uestcoelectronics/pressure_transmitter/PIN_MAPPING.xlsx

Sheet: Standards Ref
Standards Reference — Diagnostic Techniques used in this FMEDA
This sheet lists the EN 61508-7:2010 Annex A techniques referenced in column J of the MCU Pin FMEDA. The product is a pressure transmitter (process-industry field device): there is no product-specific functional-safety standard for pressure transmitters (EN 50402 applies to gas detection systems only) — the certification basis is EN 61508-1…-7:2010, applied together with IEC EN 61511-1 for use as a SIF sensor in the process sector. Diagnostic Coverage (DC) values are taken from EN 61508-2:2010 Annex A (Tables A.2–A.14) / EN 61508-7 Annex A as guidance ceilings; the value claimed in column K must be justified per pin in the FMEDA report.
Code | Technique / Measure | EN 61508-7 Reference | Max DC (guidance) | EN 61508-2:2010 Annex A Ref | Where applied in this FMEDA
A.3 | Frequency monitoring | EN 61508-7 A.3 | High (≥99%) | Table A.11 (clock) | HSE / LSE clock cross-check (PC14, PC15, PH0, PH1)
A.4 | Configuration / CPU-register test | EN 61508-7 A.4 | Medium (60-90%) | Table A.4 (processing units) | GPIO configuration check, boot-mode option-byte (PA2, PA15-debug, PH3-BOOT0)
A.5 | RAM test — March-X / March-C− / walking bit | EN 61508-7 A.5 | High (≥99%) | Table A.6 (variable memory ranges) | Background RAM test (linked to VCAP / VDD)
A.6 | Self-test by software | EN 61508-7 A.6 | Medium (60-90%) | Table A.4 (processing units) | Register read-back tests on SPI / I2C, IRQ liveness, injection test on AFE
A.7 | Test pattern / Read-back of outputs / CRC | EN 61508-7 A.7 (A.7.4 = CRC, A.7.5 = time-redundancy) | High (≥99%) | Table A.7 (I/O units), Table A.8 (data paths) | Read-back of digital outputs (BLE_PWR_ON, RST#TI), CRC on RS-485 / SPI / I2C frames, 4-20 mA sweep test
A.8 | Voltage control (over-/under-voltage) | EN 61508-7 A.8 | Medium (60-90%) | Table A.9 (power supply) | BOR + PVD + PVM on VDD / VDDA / VBAT
A.9 | Clock monitoring | EN 61508-7 A.9 | High (≥99%) | Table A.11 (clock) | HSE CSS + LSE/LSI cross-check (XTAL pins, CLK_EN)
A.10 | Watchdog — windowed, 1oo2 with separate time-base | EN 61508-7 A.10 | High (≥99%) | Table A.10 (program sequence) | External window WDT (WDI, NRST), internal IWDG
A.11 | Input comparison / voting (1oo2, 1oo3) | EN 61508-7 A.11 | High (≥99%) | Table A.13 (sensors) | 1oo2 thermistors, 1oo3 Hall switches
A.13 | Analog signal monitoring — range / plausibility | EN 61508-7 A.13 | Medium (60-90%) | Table A.13 (sensors), Table A.7 (I/O units) | All ADC channels (TMP_ADC1/2, VCC_FB, Current_OUT_FB)
A.14 | Test by redundant hardware | EN 61508-7 A.14 | Medium (60-90%) | Table A.8 (data paths) | Echo-test of RS-485 (TI_RTS / LP_UART)
A.16 | Program sequence monitoring | EN 61508-7 A.16 | High (≥99%) | Table A.10 (program sequence) | Token-based watchdog kick (WDI)
A.18 | Protection against unauthorised modification | EN 61508-7 A.18 | Systematic (n/a for DC) | Systematic — EN 61508-2 Tables A.15–A.17; EN 61508-3 (software) | RDP locked, SWD disabled in production (SWDIO, SWCLK, SWO)
Pin direction codes used in column D:
DI = digital input
DO = digital output
DI/O = digital bidirectional / open-drain
AI = analog input
AO = analog output
PWR-IN = supply pin (in)
PWR-GND = ground pin
Conventions / scope:
1. "Safety related" (column F) = YES means the pin participates in the safety function (pressure measurement → 4-20 mA loop → safe-state signalling); the device is the sensor element of a Safety Instrumented Function per IEC EN 61511-1, with the safety function defined per EN 61508-4.
2. "Claimed DC" (column K) is a target value; the FMEDA report (separate document) must justify the value with technique-specific arguments per EN 61508-7 Annex A.
3. Failure modes follow EN 61508-2 Table B.2 (digital I/O) and §7.4.7 (FMEDA technique).
4. Where a non-safety function shares an MCU with a safety function, EN 61508-2 §7.4.2.3 (independence) and EN 61508-3 Annex F (non-interference between software elements) are invoked: non-safety pins must not be able to interfere with the safety output.
5. Diagnostic test intervals shall meet the proof-test interval declared in the system safety manual (typ. < T_PT/100 per EN 61508-2 §7.4.5.2).
Applicable standards for this product (pressure transmitter, SIL 2):
EN 61508-1…-7:2010 — Functional safety of E/E/PE safety-related systems. Certification basis; FMEDA per Part 2 §7.4.7, diagnostic techniques per Part 7 Annex A, DC ceilings per Part 2 Annex A (Tables A.2–A.14).
IEC EN 61511-1 — Functional safety: Safety Instrumented Systems for the process industry sector. Governs application of the transmitter as the sensor element of a SIF.
EN 61326-3-1 — EMC: immunity requirements for safety-related systems and equipment intended to perform safety-related functions (functional safety, SIL 1–3), general industrial applications.
IEC 60770-1 / IEC 60770-3 — Transmitters for use in industrial-process control systems: methods for performance evaluation (Part 3: intelligent transmitters).
Note: EN 50402 (electrical apparatus for the detection of combustible/toxic gases — functional safety of fixed gas detection systems) applies to gas detectors only and has been removed from this FMEDA's reference set.

Sheet: MCU Pin Map
MCU Pin Map — STM32U385RGT7 (U400 / B403)
Package: LQFP64 • Schematic: Schematic Prints.PDF, Sheet 4/7 • Project: Pressure Transmitter
Pin # | Port / Pad Name | Schematic Net | Pin Mode | Peripheral / AF | 4-20 mA | 4-20 mA + HART | LP HART | LP PA | MODBUS | Notes / Diagnostic Ref
1 | VBAT | 3V | Power | — | 3V supply — VBAT (tied to 3V_MAIN; no coin cell) | 3V supply — VBAT (tied to 3V_MAIN; no coin cell) | 3V supply — VBAT (tied to 3V_MAIN; no coin cell) | 3V supply — VBAT (tied to 3V_MAIN; no coin cell) | 3V supply — VBAT (tied to 3V_MAIN; no coin cell) | Supply pin. Diag: continuous VCC monitoring via PC4/VCC_FB ADC (EN 61508-7 A.8 'Power supply monitoring with safety shut-off'; EN 50402 §6.4.4).
2 | PC13 | SW_HALL3 | GPIO Input | GPIO / EXTI13 | SW_HALL3 — Hall switch #3 (U302 AH1913) | SW_HALL3 — Hall switch #3 (U302 AH1913) | SW_HALL3 — Hall switch #3 (U302 AH1913) | SW_HALL3 — Hall switch #3 (U302 AH1913) | SW_HALL3 — Hall switch #3 (U302 AH1913) | Hall input. Diag: cross-comparison with SW_HALL1/SW_HALL2 + plausibility (EN 61508-7 A.4 'Test pattern'; EN 50402 §6.4.7).
3 | PC14-OSC32_IN | XTAL_LF_1 | Oscillator | RCC LSE input | LSE crystal IN — X400 (32.768 kHz) | LSE crystal IN — X400 (32.768 kHz) | LSE crystal IN — X400 (32.768 kHz) | LSE crystal IN — X400 (32.768 kHz) | LSE crystal IN — X400 (32.768 kHz) | LSE clock. Diag: clock-frequency monitoring vs HSE/HSI (EN 61508-7 A.3 'Watch-dog with separate time base'; EN 50402 §6.4.3).
4 | PC15-OSC32_OUT | XTAL_LF_2 | Oscillator | RCC LSE output | LSE crystal OUT — X400 (32.768 kHz) | LSE crystal OUT — X400 (32.768 kHz) | LSE crystal OUT — X400 (32.768 kHz) | LSE crystal OUT — X400 (32.768 kHz) | LSE crystal OUT — X400 (32.768 kHz) | LSE clock. Diag: see pin 3 — frequency cross-check (EN 61508-7 A.3, A.9 'Frequency monitoring'; EN 50402 §6.4.3).
5 | PH0-OSC_IN | XTAL_HF_1 | Oscillator | RCC HSE input | HSE crystal IN — X401 (HF crystal) | HSE crystal IN — X401 (HF crystal) | HSE crystal IN — X401 (HF crystal) | HSE crystal IN — X401 (HF crystal) | HSE crystal IN — X401 (HF crystal) | HSE clock. Diag: CSS (Clock-Security-System) HW failover + frequency monitor (EN 61508-7 A.3, A.9; EN 50402 §6.4.3).
6 | PH1-OSC_OUT | XTAL_HF_2 | Oscillator | RCC HSE output | HSE crystal OUT — X401 (HF crystal) | HSE crystal OUT — X401 (HF crystal) | HSE crystal OUT — X401 (HF crystal) | HSE crystal OUT — X401 (HF crystal) | HSE crystal OUT — X401 (HF crystal) | HSE clock. Diag: see pin 5 — CSS interrupt on HSE failure (EN 61508-7 A.3, A.9; EN 50402 §6.4.3).
7 | NRST | MCU_RESET# | Reset (bidir, OD) | System reset | MCU_RESET# — external WDT/supervisor reset (page 5) | MCU_RESET# — external WDT/supervisor reset (page 5) | MCU_RESET# — external WDT/supervisor reset (page 5) | MCU_RESET# — external WDT/supervisor reset (page 5) | MCU_RESET# — external WDT/supervisor reset (page 5) | Reset input. Diag: external WDT timeout + supervisor brown-out (EN 61508-7 A.10 'Watch-dog'; EN 50402 §6.4.10).
8 | PC0 | TMP_ADC1 | Analog Input | ADC1_IN1 | TMP_ADC1 — thermistor analog input | TMP_ADC1 — thermistor analog input | TMP_ADC1 — thermistor analog input | TMP_ADC1 — thermistor analog input | TMP_ADC1 — thermistor analog input | Analog input. Diag: dual-thermistor diversity + range/plausibility check (EN 61508-7 A.13 'Analog signal monitoring'; EN 50402 §6.4.5).
9 | PC1 | TMP_ADC2 | Analog Input | ADC1_IN2 | TMP_ADC2 — thermistor analog input | TMP_ADC2 — thermistor analog input | TMP_ADC2 — thermistor analog input | TMP_ADC2 — thermistor analog input | TMP_ADC2 — thermistor analog input | Analog input. Diag: see pin 8 — redundant thermistor pair (EN 61508-7 A.13, A.14 'HW redundancy'; EN 50402 §6.4.5).
10 | PC2 | BLE_PWR_ON | GPIO Output (PP) | GPIO | BLE_PWR_ON — BLE module power enable (B600/U600) | BLE_PWR_ON — BLE module power enable (B600/U600) | BLE_PWR_ON — BLE module power enable (B600/U600) | BLE_PWR_ON — BLE module power enable (B600/U600) | BLE_PWR_ON — BLE module power enable (B600/U600) | BLE enable. Diag: read-back via GPIO + BLE comms heartbeat (EN 61508-7 A.6 'Self-test by SW'; EN 50402 §6.4.8).
11 | PC3 | WDI | GPIO Output (PP) | GPIO / timer kick | WDI — external watchdog input (page 5) | WDI — external watchdog input (page 5) | WDI — external watchdog input (page 5) | WDI — external watchdog input (page 5) | WDI — external watchdog input (page 5) | Watchdog kick. Diag: external WDT requires periodic toggle; missed kick triggers reset (EN 61508-7 A.10; EN 50402 §6.4.10).
12 | VSSA | GND | Power | — | Analog ground | Analog ground | Analog ground | Analog ground | Analog ground | Analog ground. Diag: PCB layout audit + ADC offset self-cal (EN 61508-7 A.13; EN 50402 §6.4.5).
13 | VDDA | 3VA | Power | — | 3VA — analog supply rail | 3VA — analog supply rail | 3VA — analog supply rail | 3VA — analog supply rail | 3VA — analog supply rail | Analog supply. Diag: ADC ratiometric self-check using V_REF (EN 61508-7 A.8, A.13; EN 50402 §6.4.4).
14 | PA0 | CD_IRQ | GPIO Input | GPIO / EXTI0 | CD_IRQ — FDC2214 capacitance-sensor interrupt (B405) | CD_IRQ — FDC2214 capacitance-sensor interrupt (B405) | CD_IRQ — FDC2214 capacitance-sensor interrupt (B405) | CD_IRQ — FDC2214 capacitance-sensor interrupt (B405) | CD_IRQ — FDC2214 capacitance-sensor interrupt (B405) | Sensor IRQ. Diag: IRQ-rate plausibility + B405 status-register polling (EN 61508-7 A.6, A.18 'Plausibility check'; EN 50402 §6.4.5).
15 | PA1 | ERRB | GPIO Input | GPIO | ERRB — FDC2214 error flag (B405) | ERRB — FDC2214 error flag (B405) | ERRB — FDC2214 error flag (B405) | ERRB — FDC2214 error flag (B405) | ERRB — FDC2214 error flag (B405) | Sensor error flag. Diag: edge-sensitive IRQ + sensor diagnostic read (EN 61508-7 A.6, A.18; EN 50402 §6.4.5).
16 | PA2 | LP_UART_TX | Unused | — | LP_UART_TX — line inactive (no HART modem, no RS-485) | LP_UART_TX — to B404 DAC8742 HART modem UART_IN (TX from MCU) | LP_UART_TX — to B404 DAC8742 HART modem UART_IN (TX from MCU) | LP_UART_TX — to B404 DAC8742 HART modem UART_IN (TX from MCU) | LP_UART_TX — to U800 SN65HVD485 driver input (RS-485 TX) | UART TX. Diag: protocol CRC + frame-error counter + read-back via UART loopback or peer ACK (EN 61508-7 A.6, A.7 'CRC'; EN 50402 §6.4.6). MODBUS: also check RS-485 DE timing; HART: modem comms heartbeat.
17 | PA3 | LP_UART_RX | AF Input | LPUART1_RX (AF8) | LP_UART_RX — line inactive (no HART modem, no RS-485) | LP_UART_RX — from B404 DAC8742 HART modem UART_OUT (RX to MCU) | LP_UART_RX — from B404 DAC8742 HART modem UART_OUT (RX to MCU) | LP_UART_RX — from B404 DAC8742 HART modem UART_OUT (RX to MCU) | LP_UART_RX — from U800 SN65HVD485 receiver output (RS-485 RX) | UART RX. Diag: protocol CRC + frame-error counter + timeout (EN 61508-7 A.7 'CRC', A.6; EN 50402 §6.4.6). MODBUS: also check RS-485 bus idle/break detection.
18 | VSS_1 | GND | Power | — | Digital ground | Digital ground | Digital ground | Digital ground | Digital ground | Ground. Diag: PCB-design measure (EN 61508-7 A.8; EN 50402 §6.4.4).
19 | VDD_1 | 3V | Power | — | 3V digital supply | 3V digital supply | 3V digital supply | 3V digital supply | 3V digital supply | Supply pin. Diag: see pin 1.
20 | PA4 | DAC_INJ | Analog Output | DAC1_OUT1 | DAC_INJ — DAC1_OUT1 drives XTR111 SET (analog 4-20mA loop-current command) | DAC_INJ — DAC1_OUT1 drives XTR111 SET (analog 4-20mA loop-current command) | DAC_INJ — unused in this variant (LP-HART loop driven by B402 via SPI on PA7) | DAC_INJ — unused in this variant | DAC_INJ — unused in this variant | Analog DAC output. In 4-20 plain variant drives XTR111 SET directly (analog loop-current command). Diag: closed-loop comparison vs Current_OUT_FB (U401 INA190 readback) + range check (EN 61508-7 A.13 'Analog signal monitoring', A.14 'HW redundancy', A.18 'Plausibility check'; EN 50402 §6.4.5).
21 | PA5 | SPI1_SCK | AF Output | SPI1_SCK (AF5) | SPI1_SCK — bus inactive (no SPI peripheral populated) | SPI1_SCK — bus inactive (B404 is UART-mode; no SPI slave) | SPI1_SCK — to B402 DAC161S997 SCLK (LP-HART loop DAC) | SPI1_SCK — bus inactive (no SPI slave in LP-PA) | SPI1_SCK — bus inactive (no SPI slave) | SPI clock. Diag: only active in LP-HART (B402 DAC161S997). Loop-back via Current_OUT_FB closed-loop verification + write-readback where DAC supports (EN 61508-7 A.6 'Self-test by SW', A.13 'Analog signal monitoring'; EN 50402 §6.4.5, §6.4.6).
22 | PA6 | FLT_4-20mA# | GPIO Input (EXTI) | EXTI6 / pull-up | FLT_4-20mA# — 4-20mA fault input from U400 XTR111 (open-drain, active-LOW, EXTI on falling edge) | FLT_4-20mA# — 4-20mA fault input from U400 XTR111 (open-drain, active-LOW, EXTI on falling edge) | FLT_4-20mA# — line inactive (U400 not populated; pin kept as input with pull-up) | FLT_4-20mA# — line inactive (U400 not populated) | FLT_4-20mA# — line inactive (no 4-20mA loop in MODBUS) | Loop fault input (active-LOW). U400 XTR111 asserts FLT on over-temperature / open-load / short. Diag: EXTI on falling edge → immediate safe-state transition; periodic high-level readback for stuck-low detection; cross-check with Current_OUT_FB (U401 INA190) at boot and at runtime. References EN 61508-7 A.6 'Self-test by SW', A.13 'Analog signal monitoring', A.14 'HW redundancy', A.18 'Plausibility check'; EN 50402 §6.4.5 (analog inputs), §6.4.7 (digital inputs), §6.4.11 (safe-state behaviour).
23 | PA7 | SPI1_MOSI | AF Output | SPI1_MOSI (AF5) | SPI1_MOSI — bus inactive (no SPI slave populated) | SPI1_MOSI — bus inactive (B404 is UART-mode) | SPI1_MOSI — to B402 DAC161S997 SDI (LP-HART loop DAC data) | SPI1_MOSI — bus inactive | SPI1_MOSI — bus inactive | SPI MOSI. Diag: only active in LP-HART (B402). Closed-loop verification via Current_OUT_FB (U401 INA190) for commanded vs measured loop current (EN 61508-7 A.13 'Analog signal monitoring', A.14 'HW redundancy', A.18 'Plausibility check'; EN 50402 §6.4.5).
24 | PC4 | VCC_FB | Analog Input | ADC1_IN13 | VCC_FB — supply rail feedback (ADC monitoring of 3V/5V via divider) | VCC_FB — supply rail feedback (ADC monitoring of 3V/5V via divider) | VCC_FB — supply rail feedback (ADC monitoring of 3V/5V via divider) | VCC_FB — supply rail feedback (ADC monitoring of 3V/5V via divider) | VCC_FB — supply rail feedback (ADC monitoring of 3V/5V via divider) | Supply feedback ADC. Diag: continuous VCC monitoring + window comparator U202 TPS3700 where present (EN 61508-7 A.8; EN 50402 §6.4.4).
25 | PC5 | Current_OUT_FB | Analog Input | ADC1_IN14 | Current_OUT_FB — loop-current sense via U401 INA190 (4-20 mA monitoring) | Current_OUT_FB — loop-current sense via U401 INA190 (4-20 mA monitoring) | Current_OUT_FB — loop-current sense via U401 INA190 (LP HART loop monitoring) | N/A — IC not populated | N/A — IC not populated | Loop-current feedback. Diag: closed-loop comparison vs commanded 4-20mA / DAC161S997 output (EN 61508-7 A.13, A.14, A.18; EN 50402 §6.4.5).
26 | PB0 | BLE_EVENT | GPIO Input | GPIO / EXTI0 | BLE_EVENT — BLE module event/IRQ input | BLE_EVENT — BLE module event/IRQ input | BLE_EVENT — BLE module event/IRQ input | BLE_EVENT — BLE module event/IRQ input | BLE_EVENT — BLE module event/IRQ input | BLE event/IRQ. Diag: IRQ-rate plausibility + BLE heartbeat (EN 61508-7 A.6, A.18; EN 50402 §6.4.8).
27 | PB1 | TI_RTS | GPIO Output (PP) | GPIO | TI_RTS — line inactive (no HART modem, no RS-485) | TI_RTS — to B404 DAC8742 UART_RTS (HART modem request-to-send) | TI_RTS — to B404 DAC8742 UART_RTS (HART modem request-to-send) | TI_RTS — to B404 DAC8742 UART_RTS (HART modem request-to-send) | TI_RTS — to U800 SN65HVD485 DE/RE (RS-485 driver/receiver enable) | Shared net TI_RTS routes to B404 UART_RTS (HART variants) OR to U800 DE/RE (MODBUS). Only one IC populated per variant → no electrical conflict. Diag: HART variants — modem RTS/CTS handshake + comms heartbeat; MODBUS — DE/RE timing verification + RS-485 echo check (EN 61508-7 A.6 'Self-test by SW', A.7 'CRC', A.18; EN 50402 §6.4.6).
28 | PB2 | SPI1_CS1 | GPIO Output (PP) / SPI1 NSS | GPIO (4-20 EN) or SPI1_NSS (LP-HART) | 4-20mA enable GPIO — HIGH = U400 XTR111 supply ON (loop output active); LOW = loop disabled (safe-state) | 4-20mA enable GPIO — HIGH = U400 XTR111 supply ON (loop output active); LOW = loop disabled (safe-state) | SPI1_CS1 — to B402 DAC161S997 chip select (LP-HART loop DAC) | PB2 — line inactive (no B402, no U400 in LP-PA) | PB2 — line inactive (no loop, no SPI slave) | Variant-multiplexed pin: in 4-20 / 4-20+HART = 4-20mA power-enable GPIO (controls U400 XTR111 supply, default LOW for safe-state at boot); in LP-HART = SPI1_CS1 to B402 DAC161S997 (active-LOW chip select). Only one role per variant (no electrical conflict). Diag — 4-20 mode: GPIO read-back at boot + closed-loop verification via Current_OUT_FB (U401 INA190) after enable; LP-HART mode: SPI write-readback where supported + closed-loop verification via Current_OUT_FB. Safe-state ensured by default LOW after reset (EN 61508-7 A.6 'Self-test by SW', A.13 'Analog signal monitoring', A.18 'Plausibility check'; EN 50402 §6.4.5, §6.4.7, §6.4.11 'Safe state behaviour').
29 | PB10 | LED_CTRL | GPIO Output (PP) | GPIO | LED drive — status / diagnostic LED (GPIO Output) | LED drive — status / diagnostic LED (GPIO Output) | LED drive — status / diagnostic LED (GPIO Output) | LED drive — status / diagnostic LED (GPIO Output) | LED drive — status / diagnostic LED (GPIO Output) | Status/diagnostic LED driver — HMI indication only, not part of safety function. Diag: GPIO read-back register check confirms commanded state (EN 61508-7 A.6 'Self-test by SW'; EN 50402 §6.4.7 'Digital outputs'). LED failure does not affect safety function — visual diagnostic is supplementary.
30 | VCAP | VCAP | Power | — | VCAP — internal LDO decoupling | VCAP — internal LDO decoupling | VCAP — internal LDO decoupling | VCAP — internal LDO decoupling | VCAP — internal LDO decoupling | Internal LDO cap. Diag: PCB-design measure (EN 50402 §6.4.4).
31 | VSS_2 | GND | Power | — | Digital ground | Digital ground | Digital ground | Digital ground | Digital ground | Ground.
32 | VDD_2 | 3V | Power | — | 3V digital supply | 3V digital supply | 3V digital supply | 3V digital supply | 3V digital supply | Supply pin.
33 | PB12 | BLE_MODE | GPIO Output (PP) | GPIO | BLE_MODE — BLE module mode select (boot/run) | BLE_MODE — BLE module mode select (boot/run) | BLE_MODE — BLE module mode select (boot/run) | BLE_MODE — BLE module mode select (boot/run) | BLE_MODE — BLE module mode select (boot/run) | BLE mode pin. Diag: read-back via GPIO (EN 61508-7 A.6; EN 50402 §6.4.7).
34 | PB13 | SCLK_DSP | AF Output | SPI2_SCK (AF5) | SCLK_DSP — to LCD400 SCL (off-BOM external display option; net routed for variant flexibility) | SCLK_DSP — to LCD400 SCL (off-BOM external display option; net routed for variant flexibility) | SCLK_DSP — display SPI clock to B407 EA DOGS104N | SCLK_DSP — display SPI clock to B407 EA DOGS104N | SCLK_DSP — to LCD400 SCL (off-BOM external display option; net routed for variant flexibility) | Display SPI clock. LP-HART / LP-PA: drives onboard B407 EA DOGS104N. 4-20 / 4-20+HART / MODBUS: routed to external LCD400 SCL header (LCD400 not in BOM — off-board option). Display is HMI only — NOT part of the SIL2 safety function. Diag: display CRC frame check + write-readback where supported; failure of display does not affect safe-state (EN 61508-7 A.7 'CRC'; EN 50402 §6.4.6, §6.4.11 'Safe state behaviour').
35 | PB14 | TFT_MISO | AF Input | SPI2_MISO (AF5) | TFT_MISO — to LCD400 FSO (off-BOM external display option; net routed for variant flexibility) | TFT_MISO — to LCD400 FSO (off-BOM external display option; net routed for variant flexibility) | TFT_MISO — display SPI MISO from B407 | TFT_MISO — display SPI MISO from B407 | TFT_MISO — to LCD400 FSO (off-BOM external display option; net routed for variant flexibility) | Display SPI MISO. LP-HART / LP-PA: from onboard B407 EA DOGS104N. 4-20 / 4-20+HART / MODBUS: routed to external LCD400 FSO header (LCD400 not in BOM — off-board option). Display is HMI only — NOT part of the SIL2 safety function. Diag: display CRC frame check + bus-stuck detection when display absent (EN 61508-7 A.5 'Test pattern', A.7 'CRC'; EN 50402 §6.4.6, §6.4.11 'Safe state behaviour').
36 | PB15 | SDA_DSP | AF Output | SPI2_MOSI (AF5) | SDA_DSP — to LCD400 SDA (off-BOM external display option; net routed for variant flexibility) | SDA_DSP — to LCD400 SDA (off-BOM external display option; net routed for variant flexibility) | SDA_DSP — display SPI MOSI to B407 | SDA_DSP — display SPI MOSI to B407 | SDA_DSP — to LCD400 SDA (off-BOM external display option; net routed for variant flexibility) | Display SPI MOSI / I²C SDA. LP-HART / LP-PA: drives onboard B407 EA DOGS104N. 4-20 / 4-20+HART / MODBUS: routed to external LCD400 SDA header (LCD400 not in BOM — off-board option). Display is HMI only — NOT part of the SIL2 safety function. Diag: display CRC frame check + write-readback where supported (EN 61508-7 A.7 'CRC'; EN 50402 §6.4.6, §6.4.11 'Safe state behaviour').
37 | PC6 | TFT_CS | GPIO Output (PP) | GPIO | TFT_CS — to LCD400 CS1 (off-BOM external display option; net routed for variant flexibility) | TFT_CS — to LCD400 CS1 (off-BOM external display option; net routed for variant flexibility) | TFT_CS — display chip select to B407 | TFT_CS — display chip select to B407 | TFT_CS — to LCD400 CS1 (off-BOM external display option; net routed for variant flexibility) | Display chip select #1. LP-HART / LP-PA: drives onboard B407 EA DOGS104N CS. 4-20 / 4-20+HART / MODBUS: routed to external LCD400 CS1 header (LCD400 not in BOM — off-board option). Display is HMI only — NOT part of the SIL2 safety function. Diag: GPIO read-back register check (EN 61508-7 A.6 'Self-test by SW'; EN 50402 §6.4.7, §6.4.11 'Safe state behaviour').
38 | PC7 | RW_DSP | GPIO Output (PP) | GPIO | RW_DSP — to LCD400 DC (data/command select; off-BOM external display option) | RW_DSP — to LCD400 DC (data/command select; off-BOM external display option) | RW_DSP — display R/W select to B407 | RW_DSP — display R/W select to B407 | RW_DSP — to LCD400 DC (data/command select; off-BOM external display option) | Display R/W or DC select. LP-HART / LP-PA: drives onboard B407 EA DOGS104N R/W. 4-20 / 4-20+HART / MODBUS: routed to external LCD400 DC header (LCD400 not in BOM — off-board option). Display is HMI only — NOT part of the SIL2 safety function. Diag: GPIO read-back register check (EN 61508-7 A.6; EN 50402 §6.4.7, §6.4.11).
39 | PC8 | RESET_DSP | GPIO Output (PP) | GPIO | RESET_DSP — to LCD400 RES (display reset; off-BOM external display option) | RESET_DSP — to LCD400 RES (display reset; off-BOM external display option) | RESET_DSP — display reset to B407 | RESET_DSP — display reset to B407 | RESET_DSP — to LCD400 RES (display reset; off-BOM external display option) | Display reset (active-LOW). LP-HART / LP-PA: drives onboard B407 EA DOGS104N RESET. 4-20 / 4-20+HART / MODBUS: routed to external LCD400 RES header (LCD400 not in BOM — off-board option). Display is HMI only — NOT part of the SIL2 safety function. Diag: GPIO read-back + display ID-readback after reset where supported (EN 61508-7 A.6; EN 50402 §6.4.7, §6.4.11).
40 | PC9 | TFT_TE | GPIO Input | GPIO / EXTI9 | TFT_TE — to LCD400 CS2 (secondary chip select; off-BOM external display option) | TFT_TE — to LCD400 CS2 (secondary chip select; off-BOM external display option) | TFT_TE — display tearing-effect input from B407 | TFT_TE — display tearing-effect input from B407 | TFT_TE — to LCD400 CS2 (secondary chip select; off-BOM external display option) | Display tearing-effect / secondary CS. LP-HART / LP-PA: tearing-effect input from B407 EA DOGS104N. 4-20 / 4-20+HART / MODBUS: routed to external LCD400 CS2 header (LCD400 not in BOM — off-board option). Display is HMI only — NOT part of the SIL2 safety function. Diag: GPIO read-back; failure does not affect safe-state (EN 61508-7 A.6; EN 50402 §6.4.7, §6.4.11).
41 | PA8 | BL1 | AF Output | TIM1_CH1 (PWM) | BL1 — to LCD400 BLK (backlight enable; off-BOM external display option) | BL1 — to LCD400 BLK (backlight enable; off-BOM external display option) | BL1 — display backlight #1 control (B407 region) | BL1 — display backlight #1 control (B407 region) | BL1 — to LCD400 BLK (backlight enable; off-BOM external display option) | Backlight #1 / LCD400 BLK. LP-HART / LP-PA: drives onboard B407 backlight control. 4-20 / 4-20+HART / MODBUS: routed to external LCD400 BLK header (LCD400 not in BOM — off-board option). HMI — NOT part of the SIL2 safety function. Diag: PWM duty / GPIO read-back (EN 61508-7 A.6; EN 50402 §6.4.7, §6.4.11).
42 | PA9 | BL2 | AF Output | TIM1_CH2 (PWM) | N/A — IC not populated | N/A — IC not populated | BL2 — display backlight #2 control (B407 region) | BL2 — display backlight #2 control (B407 region) | N/A — IC not populated | Backlight #2. Diag: see pin 41.
43 | PA10 | LCD_PWR_ON | GPIO Output (PP) | GPIO | LCD_PWR_ON — display power enable (B407 and LCD400 region) | LCD_PWR_ON — display power enable (B407 and LCD400 region) | LCD_PWR_ON — display power enable (B407 and LCD400 region) | LCD_PWR_ON — display power enable (B407 and LCD400 region) | N/A — IC not populated | LCD power. Diag: GPIO read-back (EN 61508-7 A.6; EN 50402 §6.4.7).
44 | PA11 | SW_HALL1 | GPIO Input | GPIO / EXTI11 | SW_HALL1 — Hall switch #1 (U300 AH1913) | SW_HALL1 — Hall switch #1 (U300 AH1913) | SW_HALL1 — Hall switch #1 (U300 AH1913) | SW_HALL1 — Hall switch #1 (U300 AH1913) | SW_HALL1 — Hall switch #1 (U300 AH1913) | Hall input. Diag: cross-comparison with SW_HALL2/3 + plausibility (EN 61508-7 A.4, A.14; EN 50402 §6.4.7).
45 | PA12 | SW_HALL2 | GPIO Input | GPIO / EXTI12 | SW_HALL2 — Hall switch #2 (U301 AH1913) | SW_HALL2 — Hall switch #2 (U301 AH1913) | SW_HALL2 — Hall switch #2 (U301 AH1913) | SW_HALL2 — Hall switch #2 (U301 AH1913) | SW_HALL2 — Hall switch #2 (U301 AH1913) | Hall input. Diag: see pin 44.
46 | PA13 | SWDIO | AF (SWD) | SYS_SWDIO (AF0) | SWDIO — SWD debug data (programming/test only) | SWDIO — SWD debug data (programming/test only) | SWDIO — SWD debug data (programming/test only) | SWDIO — SWD debug data (programming/test only) | SWDIO — SWD debug data (programming/test only) | Debug only. Diag: locked in production firmware (EN 61508-7 A.18 'Protection'; EN 50402 §6.4.11).
47 | VSS_3 | GND | Power | — | Digital ground | Digital ground | Digital ground | Digital ground | Digital ground | Ground.
48 | VDDUSB | 3V | Power | — | VDDUSB — tied to 3V (USB IP unused) | VDDUSB — tied to 3V (USB IP unused) | VDDUSB — tied to 3V (USB IP unused) | VDDUSB — tied to 3V (USB IP unused) | VDDUSB — tied to 3V (USB IP unused) | USB supply tied to 3V. Diag: USB IP disabled in firmware (EN 61508-7 A.18; EN 50402 §6.4.11).
49 | PA14 | SWCLK | AF (SWD) | SYS_SWCLK (AF0) | SWCLK — SWD debug clock (programming/test only) | SWCLK — SWD debug clock (programming/test only) | SWCLK — SWD debug clock (programming/test only) | SWCLK — SWD debug clock (programming/test only) | SWCLK — SWD debug clock (programming/test only) | Debug only. Diag: see pin 46.
50 | PA15 | BLE_RESET | GPIO Output (OD) | GPIO open-drain | BLE_RESET — BLE module reset | BLE_RESET — BLE module reset | BLE_RESET — BLE module reset | BLE_RESET — BLE module reset | BLE_RESET — BLE module reset | BLE reset. Diag: read-back via GPIO + BLE heartbeat (EN 61508-7 A.6; EN 50402 §6.4.8).
51 | PC10 | BLE_RXD | AF Input | USART3_RX (AF7) | BLE_RXD — UART RX from BLE module | BLE_RXD — UART RX from BLE module | BLE_RXD — UART RX from BLE module | BLE_RXD — UART RX from BLE module | BLE_RXD — UART RX from BLE module | BLE UART RX. Diag: protocol CRC + frame error counter (EN 61508-7 A.7; EN 50402 §6.4.6, §6.4.8).
52 | PC11 | BLE_TXD | AF Output | USART3_TX (AF7) | BLE_TXD — UART TX to BLE module | BLE_TXD — UART TX to BLE module | BLE_TXD — UART TX to BLE module | BLE_TXD — UART TX to BLE module | BLE_TXD — UART TX to BLE module | BLE UART TX. Diag: see pin 51.
53 | PC12 | RST#TI | GPIO Output (PP) | GPIO | RST#TI — net inactive (B404 not populated) | RST#TI — reset to B404 DAC8742 HART modem (active-low) | RST#TI — reset to B404 DAC8742 HART modem (active-low) | RST#TI — reset to B404 DAC8742 HART modem (active-low) | RST#TI — net inactive (B404 not populated) | HART modem reset. Diag: GPIO read-back + modem comms heartbeat (EN 61508-7 A.6, A.7; EN 50402 §6.4.6).
54 | PD2 | CLK_EN | GPIO Output (PP) | GPIO | CLK_EN — enables X403 (B405 FDC2214 oscillator) | CLK_EN — enables X402 (B404 HART modem XO) + X403 (B405 FDC2214 XO) | CLK_EN — enables X402 (B404 HART modem XO) + X403 (B405 FDC2214 XO) | CLK_EN — enables X402 (B404 HART modem XO) + X403 (B405 FDC2214 XO) | CLK_EN — enables X403 (B405 FDC2214 oscillator); X402 absent (no HART modem) | Oscillator enable for FDC2214 (and HART modem XO where populated). Loss → loss of capacitance measurement / HART link. Diag: I2C transaction-success rate on B405 + modem-link heartbeat where applicable; clock-frequency monitor (EN 61508-7 A.3 'Watch-dog with separate time base', A.6, A.9 'Frequency monitoring'; EN 50402 §6.4.3, §6.4.6).
55 | PB3 | SWO | AF Output | SYS_JTDO-SWO (AF0) | SWO — SWD trace output (debug only) | SWO — SWD trace output (debug only) | SWO — SWD trace output (debug only) | SWO — SWD trace output (debug only) | SWO — SWD trace output (debug only) | SWD trace, debug only. Diag: see pin 46.
56 | PB4 | TEST_MODE | GPIO Input | GPIO | TEM_MEAS_ON temperature measurement diode bias. / TEST_MODE — production test-mode input (tied/jumper) | TEM_MEAS_ON temperature measurement diode bias. / TEST_MODE — production test-mode input (tied/jumper) | TEM_MEAS_ON temperature measurement diode bias. / TEST_MODE — production test-mode input (tied/jumper) | TEM_MEAS_ON temperature measurement diode bias. / TEST_MODE — production test-mode input (tied/jumper) | TEM_MEAS_ON temperature measurement diode bias. / TEST_MODE — production test-mode input (tied/jumper) | Test mode. Diag: locked low in safety operation; checked at boot (EN 61508-7 A.18; EN 50402 §6.4.11). Measurement on for temp diodes.
57 | PB5 | FLT_TEMP# | GPIO Input | GPIO / EXTI5 | FLT_TEMP# — temperature fault from B701 TMP108 | FLT_TEMP# — temperature fault from B701 TMP108 | FLT_TEMP# — temperature fault from B701 TMP108 | FLT_TEMP# — temperature fault from B701 TMP108 | FLT_TEMP# — temperature fault from B701 TMP108 | Temp fault input. Diag: TMP108 over/under-temp alert + range cross-check vs TMP_ADC1/2 (EN 61508-7 A.13, A.14, A.18; EN 50402 §6.4.5).
58 | PB6 | SD | GPIO Output (PP) | GPIO | SD — shutdown control to B405 FDC2214 | SD — shutdown control to B405 FDC2214 | SD — shutdown control to B405 FDC2214 | SD — shutdown control to B405 FDC2214 | SD — shutdown control to B405 FDC2214 | Sensor shutdown. Diag: GPIO read-back + sensor wake confirmation (EN 61508-7 A.6; EN 50402 §6.4.7).
59 | PB7 | INT_B | GPIO Input | GPIO / EXTI7 | INT_B — interrupt from B405 FDC2214 | INT_B — interrupt from B405 FDC2214 | INT_B — interrupt from B405 FDC2214 | INT_B — interrupt from B405 FDC2214 | INT_B — interrupt from B405 FDC2214 | Sensor interrupt. Diag: IRQ-rate plausibility + status-register polling (EN 61508-7 A.6, A.18; EN 50402 §6.4.5).
60 | PH3-BOOT0 | BOOT0 | Boot select | BOOT0 input | BOOT0 — MCU boot-mode select (tied/jumper) | BOOT0 — MCU boot-mode select (tied/jumper) | BOOT0 — MCU boot-mode select (tied/jumper) | BOOT0 — MCU boot-mode select (tied/jumper) | BOOT0 — MCU boot-mode select (tied/jumper) | Boot select. Diag: tied/strapped; checked at boot (EN 61508-7 A.18; EN 50402 §6.4.11).
61 | PB8 | I2C1_SCL | AF (OD) | I2C1_SCL (AF4) | I2C1_SCL — I2C bus clock (B405 FDC2214, B701 TMP108, EEPROM) | I2C1_SCL — I2C bus clock (B405 FDC2214, B701 TMP108, EEPROM) | I2C1_SCL — I2C bus clock (B405 FDC2214, B701 TMP108, EEPROM) | I2C1_SCL — I2C bus clock (B405 FDC2214, B701 TMP108, EEPROM) | I2C1_SCL — I2C bus clock (B405 FDC2214, B701 TMP108, EEPROM) | I2C SCL. Diag: per-transaction ACK + CRC where supported + bus-stuck detection (EN 61508-7 A.7; EN 50402 §6.4.6).
62 | PB9 | I2C1_SDA | AF (OD) | I2C1_SDA (AF4) | I2C1_SDA — I2C bus data (B405 FDC2214, B701 TMP108, EEPROM) | I2C1_SDA — I2C bus data (B405 FDC2214, B701 TMP108, EEPROM) | I2C1_SDA — I2C bus data (B405 FDC2214, B701 TMP108, EEPROM) | I2C1_SDA — I2C bus data (B405 FDC2214, B701 TMP108, EEPROM) | I2C1_SDA — I2C bus data (B405 FDC2214, B701 TMP108, EEPROM) | I2C SDA. Diag: see pin 61.
63 | VSS_4 | GND | Power | — | Digital ground | Digital ground | Digital ground | Digital ground | Digital ground | Ground.
64 | VDD_3 | 3V | Power | — | 3V digital supply | 3V digital supply | 3V digital supply | 3V digital supply | 3V digital supply | Supply pin.
