uestcoelectronics/pressure_transmitter/BOM/PCBPT910G1_4_20.xlsx

Designator | Footprint | Final Part Number
B403 | QFP50P1200X1200X160-64N | STM32U385RGT7
B405 | QFN50P400X400X80-17N | FDC2214RGHR
B700 | Button 2.7x3mmx1.4mm | TBE-Q-T/R
B701 | BGA6C40P2X3_79X119X62 | TMP108AIYFFT
C100 | C0603 | GRM188R6YA106MA73D
C101 | C0603 | CL10A105KL8NNNC
C102 | C0603 | CL10A105KL8NNNC
C103 | C0603 | GRM188R6YA106MA73D
C104 | C1206 | C1206X102KGRACAUTO
C105 | C0805 | GRM21BC72A105KE01L
C106 | C0402 | GRM155R61H224KE01W
C107 | C0402 | CC0402KRX5R9BB104
C108 | C0402 | CC0402KRX5R9BB104
C109 | ALUM THT F5 D8 H11 | PKRM-050V101MF115-T/A5.0
C111 | C1206 | C1206X102KGRACAUTO
C112 | CAP 1206_3216 - 0.8MM | CC1206KFX7RDBB102
C113 | CAP 1206_3216 - 0.8MM | CC1206KFX7RDBB102
C200 | C0402 | GRM155R62A104KE14D
C201 | C0603 | CL10A226MO7JZNC
C202 | C0603 | CL10A226MO7JZNC
C203 | C0603 | CL10A226MO7JZNC
C204 | C0603 | CL10A226MO7JZNC
C205 | C0603 | CL10A226MO7JZNC
C206 | C0603 | CL10A226MO7JZNC
C207 | C0402 | GRM155R61H105KE05D
C208 | C0402 | GRM155R61H105KE05D
C209 | C0402 | GRM1555C1H3R3CA01D
C210 | C0402 | CC0402KRX5R9BB104
C211 | C0402 | CL05A105KP5NNNC
C212 | C0402 | CC0402KRX5R9BB104
C213 | C0402 | CL05A105KP5NNNC
C214 | C0402 | CC0402KRX5R9BB104
C215 | C0402 | CC0402KRX5R9BB104
C216 | C0402 | CC0402KRX5R9BB104
C217 | C0402 | CL05A105KP5NNNC
C218 | C0402 | CL05A105KP5NNNC
C219 | C0402 | CL05A105KP5NNNC
C220 | C0402 | CL05A105KP5NNNC
C221 | C0402 | CC0402KRX5R9BB104
C222 | C0402 | CC0402KRX5R9BB104
C223 | C0402 | CL05A105KP5NNNC
C224 | C0402 | CL05A105KP5NNNC
C225 | C0402 | CC0402KRX5R9BB104
C300 | C0402 | CC0402KRX5R9BB104
C301 | C0402 | CC0402KRX5R9BB104
C302 | C0402 | CC0402KRX5R9BB104
C400 | C0402 | GRM155R61H105KE05D
C401 | C0402 | CC0402KRX5R9BB104
C402 | C0402 | CC0402KRX5R9BB104
C403 | C0402 | CC0402KRX5R9BB104
C404 | C0402 | CC0402KRX7R9BB103
C405 | C0402 | CC0402KRX5R9BB104
C406 | C0402 | CC0402KRX5R9BB104
C416 | C0402 | CC0402JRNPO9BN120
C417 | C0402 | CC0402JRNPO9BN120
C418 | C0402 | CC0402JRNPO9BN120
C419 | C0402 | CC0402JRNPO9BN120
C420 | C0402 | C0402C102J5RACTU
C421 | C0402 | CC0402KRX5R9BB104
C423 | C0402 | CL05A106MP5NUNC
C424 | C0402 | GRM155R61H105KE05D
C425 | C0402 | GRM155R61H105KE05D
C426 | C0402 | GRM155R61H105KE05D
C435 | C0402 | CL05A106MP5NUNC
C436 | C0402 | GRM155R61H105KE05D
C437 | C0402 | GRM155D81C475ME15J
C438 | C0402 | CC0402KRX5R9BB104
C445 | C0402 | CC0402KRX5R9BB104
C447 | C0402 | CL05A106MP5NUNC
C452 | C0402 | GRM155R61H105KE05D
C459 | C0402 | GRM155R61H105KE05D
C460 | C0402 | GRM155R61H105KE05D
C461 | C0402 | GRM155R61H105KE05D
C462 | C0402 | GRM155R61H105KE05D
C500 | C0603 | CC0603MRX5R6BB106
C501 | C0402 | CC0402KRX5R9BB104
C700 | C0402 | CC0402KRX5R9BB104
C701 | C0402 | CC0402KRX5R9BB104
C702 | C0402 | CC0402KRX5R9BB104
C703 | C0402 | CC0402KRX5R9BB104
C705 | C0402 | CL05A106MP5NUNC
C706 | C0402 | CL05A106MP5NUNC
C707 | C0402 | CL05A106MP5NUNC
C708 | C0402 | CC0402KRX7R9BB103
D100 | DO214AB | SMDJ36CA/TR7
D101 | SOD123 | MMSZ5262BT1G
D102 | SOD-523 | PMEG6002EB,115
D103 | DO214AB | SMDJ36CA/TR7
D201 | SOD-523 | MM5Z5V1ST1G
D202 | SOD-523 | MM5Z5V1ST1G
D400 | SOD-523 | PMEG6002EB,115
D401 | SOD-523 | PMEG6002EB,115
D402 | DO214AC | SMAJ40CA
D403 | SOD-523 | PMEG6002EB,115
D404 | SOD-523 | PMEG6002EB,115
D700 | SOD-523 | PMEG6002EB,115
FB101 | FER 1206_3216 | 2512063007Y0
FB102 | FER 1206_3216 | 2512063007Y0
FB400 | FB0402 | BLM15AG102SN1D
FB401 | FB0402 | BLM15AG102SN1D
FB402 | FB0402 | BLM15AG102SN1D
FB403 | FB0402 | BLM15AG102SN1D
FB404 | FB0402 | BLM15AG102SN1D
FB405 | FB0402 | BLM15AG102SN1D
FB406 | FB0402 | BLM15AG102SN1D
FB407 | FB0402 | BLM15AG102SN1D
J100 | PHOENIX_1984772 | 1984772
J400 | SAMTEC_FTSH-105-01-L-DV-007 | FTSH-105-01-L-DV-007-K
J401 | CONN08_878320828_MOL | 878320828
J402 | CONN08_878320828_MOL | 878320828
J500 | CONN 5x2.54MM | KLS1-207-1-40-S-3X5.5X11
L200 | SMD2_CDRH127_SUM | CDRH127/LDNP-330MC
L400 | C0805 | MLF2012E6R8JT000
L401 | C0805 | MLF2012E6R8JT000
L402 | C0805 | MLF2012E6R8JT000
L403 | C0805 | MLF2012E6R8JT000
LCD400 | BDS154S10Z0TG01 | BDS154S10Z0TG01
LD400 | LED0603 RED | LTST-C190KRKT
P700 | HDR1X2 | M20-9990246
PTC100 | PTC 1812 | 0ZCG0050AF2C
Q100 | PowerPAK SO-8 Dual | SI7938DP-T1-GE3
Q200 | 6-DFN2020 (2.08X2.08) | DMP2065UFDB-7
Q401 | SC-70-6 PowerPAK® | SIA441DJ-T1-GE3
Q402 | SOT23 | MMBT5087LT1G
Q403 | SOT23 | BC817-40LT3G
Q404 | SOT223 | SIHFL9014TR-GE3
Q406 | SOT23 | BC817-40LT3G
Q700 | SOT323, SC70 | PDTC123JU,115
Q701 | SOT323, SC70 | PDTC123JU,115
Q702 | SOT323, SC70 | PDTC123JU,115
R101 | R0402 | RC0402FR-0710KP
R103 | R0402 | RC0402FR-07100KL
R104 | R0402 | RC0402FR-07100KL
R105 | R0402 | RC0402FR-0715KL
R106 | R0402 | RC0402FR-133K74L
R107 | R0402 | RC0402FR-07100KL
R108 | R0402 | RC0402FR-076K8L
R109 | R0402 | RC0402FR-0710KP
R111 | R0603 | RC0603JR-070RL
R202 | R0402 | RC0402FR-07100KL
R203 | R0402 | ERA-2AEB563X
R204 | R0402 | RC0402JR-070RL
R205 | R0402 | RC0402JR-071KL
R206 | R0402 | RC0402FR-07100KL
R207 | R0402 | RC0402FR-074K42L
R208 | R0402 | RC0402FR-0722KL
R210 | R0402 | RC0402FR-07100KL
R211 | R0402 | RC0402FR-07100KL
R212 | R0402 | RC0402FR-071KL
R213 | R0402 | RC0402FR-076K8L
R214 | R0402 | ERA-2AEB563X
R215 | R0402 | RC0402JR-070RL
R217 | R0402 | ERA-2ARB132X
R218 | R0402 | ERA-2AEB8061X
R219 | R0402 | RC0402FR-07100KL
R220 | R0402 | RC0402JR-070RL
R221 | R0402 | RC0402FR-07100KL
R223 | R0402 | RC0402FR-0722KL
R224 | C0402 | CC0402KRX7R9BB103
R225 | R0402 | CRCW040264K9FKED
R226 | R0402 | RC0402JR-070RL
R227 | R0402 | RC0402FR-0724K9L
R228 | R0402 | RC0402FR-074K42L
R230 | R0402 | RC0402FR-07100KL
R231 | R0402 | RC0402FR-07100KL
R232 | R0402 | RC0402JR-070RL
R233 | R0402 | RC0402JR-071KL
R235 | R0402 | RC0402FR-07100KL
R236 | R0402 | RC0402FR-07100KL
R237 | R0402 | RC0402JR-070RL
R238 | R0402 | RC0402JR-071KL
R300 | R0402 | RC0402JR-071KL
R301 | R0402 | RC0402JR-071KL
R302 | R0402 | RC0402JR-071KL
R303 | R0402 | RC0402JR-071KL
R304 | R0402 | RC0402JR-071KL
R305 | R0402 | RC0402JR-071KL
R400 | R0402 | RC0402FR-07100KL
R401 | R0402 | RC0402JR-070RL
R402 | R0603 | RC0603FR-0715RL
R403 | R0402 | RC0402FR-07100KL
R406 | R0603 | RT0603DRE071RL
R408 | R0402 | RT0402BRD0734K8L
R409 | R0402 | RT0402BRD071K2L
R410 | R0402 | RC0402JR-071KL
R411 | R0402 | RC0402FR-07100KL
R412 | R0402 | RC0402FR-133K74L
R413 | R0402 | RC0402FR-0710KP
R433 | R0402 | RC0402FR-07100KL
R434 | R0402 | RC0402JR-0710KL
R435 | R0402 | RC0402JR-0710KL
R437 | R0402 | RC0402JR-070RL
R438 | R0402 | RC0402JR-071KL
R439 | R0402 | RC0402JR-0710KL
R440 | R0402 | RC0402FR-07100KL
R441 | R0603 | RC0603JR-070RL
R442 | R0402 | RC0402FR-07100KL
R443 | R0603 | RC0603JR-070RL
R444 | R0603 | TNPU060327K0AYEN00
R447 | R0603 | RC0603JR-070RL
R451 | R0603 | RC0603JR-070RL
R453 | R0603 | TNPU060327K0AYEN00
R454 | R0603 | RC0603JR-070RL
R456 | R0603 | RC0603JR-070RL
R457 | R0402 | CRCW040210R0FKED
R462 | R0603 | RC0603JR-070RL
R465 | R0402 | RC0402JR-070RL
R466 | R0603 | RC0603JR-070RL
R469 | R0402 | RC0402JR-070RL
R470 | R0402 | RC0402JR-070RL
R473 | R0402 | RC0402JR-070RL
R474 | R0603 | RC0603JR-070RL
R481 | R0402 | CRCW040210R0FKED
R493 | R0402 | RC0402JR-070RL
R507 | R0402 | RC0402FR-133K74L
R508 | R0402 | RC0402FR-071KL
R509 | R0402 | RC0402FR-071KL
R513 | R0402 | RC0402JR-070RL
R515 | R0402 | RC0402JR-070RL
R516 | R0402 | RC0402FR-07100KL
R517 | R0402 | RC0402FR-07100KL
R518 | R0402 | RC0402FR-07100KL
R519 | R0402 | RC0402FR-07100KL
R520 | R0402 | RC0402FR-07100KL
R521 | R0402 | RC0402JR-070RL
R522 | R0402 | RC0402JR-070RL
R523 | R0402 | RC0402JR-070RL
R524 | R0402 | RC0402FR-07100KL
R526 | R0402 | RC0402FR-07100KL
R527 | R0402 | RC0402JR-070RL
R529 | R0402 | RC0402JR-070RL
R530 | R0402 | RC0402JR-070RL
R531 | R0402 | RC0402JR-070RL
R532 | R0402 | RC0402JR-070RL
R533 | R0402 | RC0402JR-070RL
R534 | R0402 | RC0402JR-0710KL
R535 | R0402 | RC0402JR-0710KL
R536 | R0402 | RC0402JR-0710KL
R537 | R0402 | RC0402JR-0710KL
R538 | R0402 | RC0402JR-0710KL
R539 | R0402 | RC0402JR-0710KL
R700 | R0402 | RC0402JR-071KL
R702 | R0402 | RC0402FR-0747KL
R703 | R0402 | RC0402FR-0747KL
R704 | R0402 | RC0402FR-07100KL
R705 | R0402 | RC0402FR-0710KP
R706 | R0402 | RC0402FR-07100KL
R707 | R0402 | RC0402JR-070RL
R708 | R0402 | RC0402FR-0747KL
R709 | R0402 | RC0402FR-0710KP
R710 | R0402 | RC0402JR-071KL
R711 | R0402 | RC0402FR-07100KL
U100 | Choke 4.7x4.5x2 | ACM4520-901-2P-T000
U101 | TSOT-23-8 | LM74502H
U102 | SC70-5 | LMV321IDCKR
U200 | DDA0008E-IPC_A | LMR38020SDDAR
U201 | DRV0006A | TPS71733QDRVRQ1
U202 | 6-WSON (1.5x1.5) | TPS3700DSER
U203 | SOT23_6 | TPS25221DBVR
U204 | 6-WSON (1.5x1.5) | TPS3700DSER
U205 | SOT23_6 | TPS25221DBVR
U206 | SOT23_6 | TPS25221DBVR
U207 | SOT23_6 | TPS25221DBVR
U300 | SOT23 | AH1913-W-7
U301 | SOT23 | AH1913-W-7
U302 | SOT23 | AH1913-W-7
U400 | 10-VSON EXP (3X3) | XTR111AIDRCR
U401 | SC70-6 | INA190A3IDCKR
U500 | DL-CC2340-B | DL-CC2340-B
U700 | DCK5 | SN74LVC1G132DCKR
U701 | 8-SON (3x3) | TPS3851H30EDRBT
VR100 | R1206 | AV30K1206201NIR1
VR400 | R1206 | AV30K1206201NIR1
X400 | 4-SMD (3.2MMX2.5MM) | C3E-24.000-12-1015-X-R
X401 | 2-SMD (1.60MM X 1.00MM) | ECS-.327-12.5-16-TR
X403 | 4-SMD (3.2MMX2.5MM) | MCSJK-3N-40.00-3.3-25-C
