uestcoelectronics/pressure_transmitter/4-20.PDF

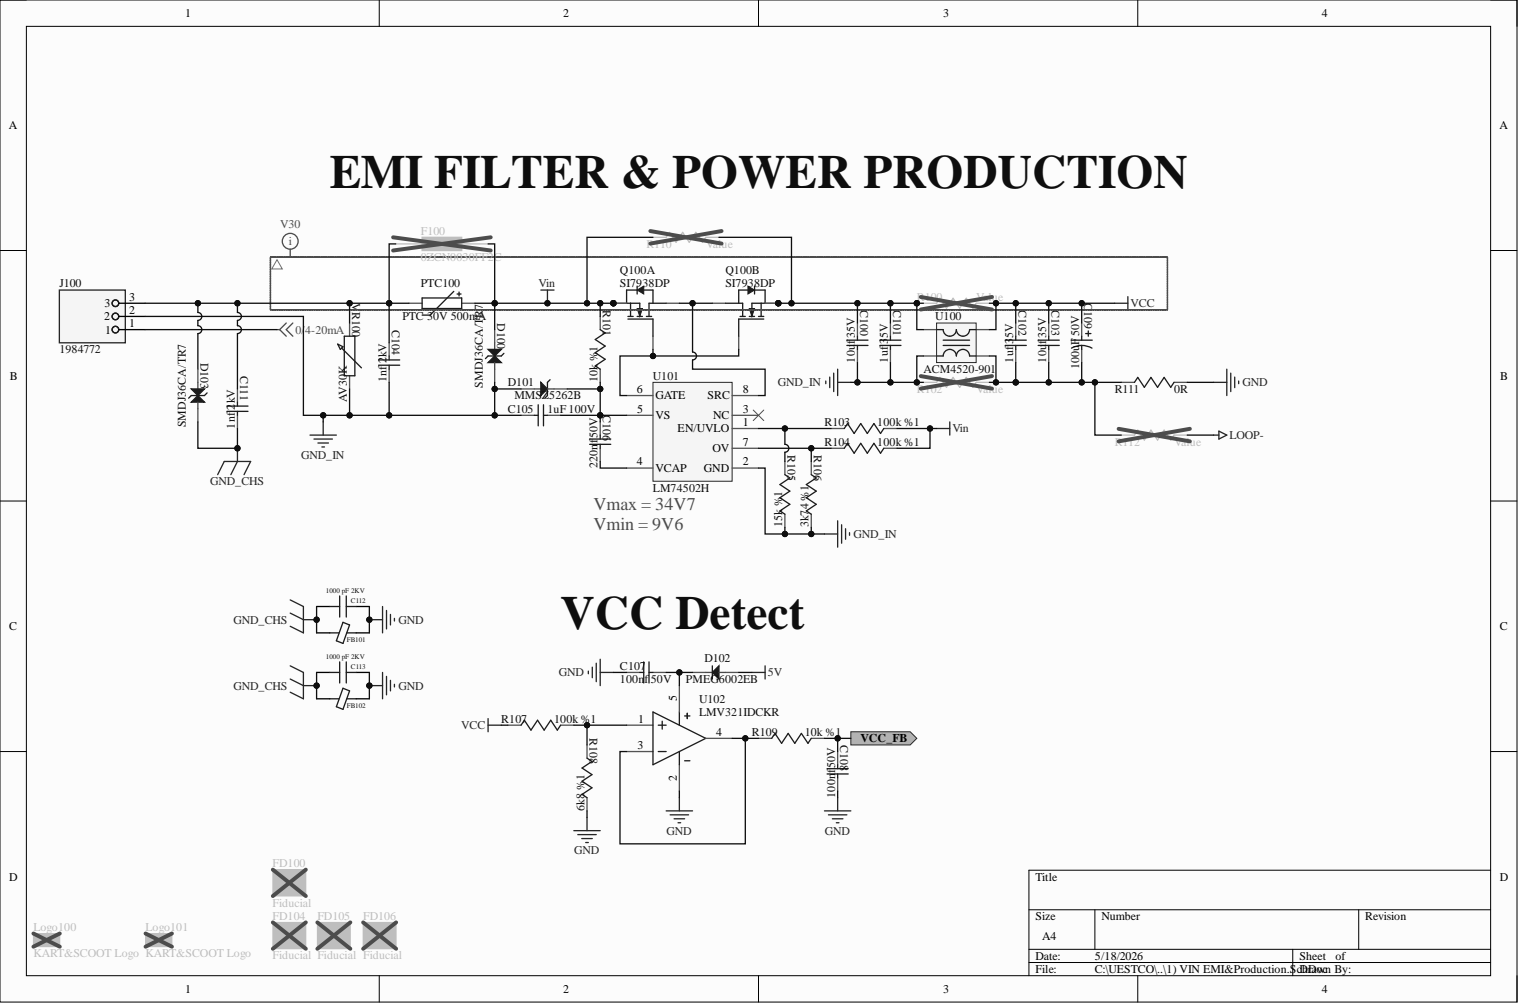
[picture p1: page 1]

EMI FILTER & POWER PRODUCTION

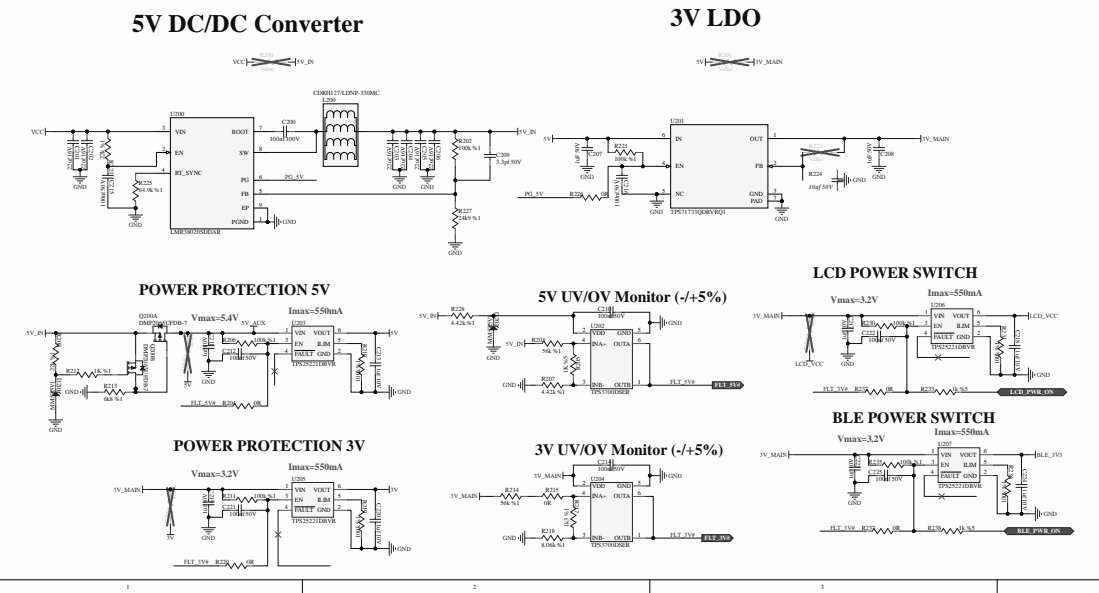
[picture p2: page 2]

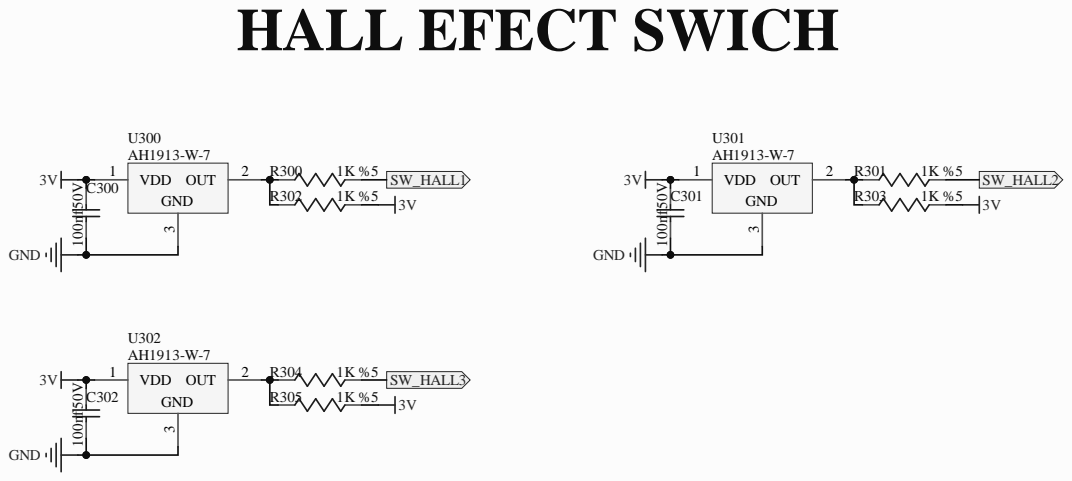
[picture p3: page 3]

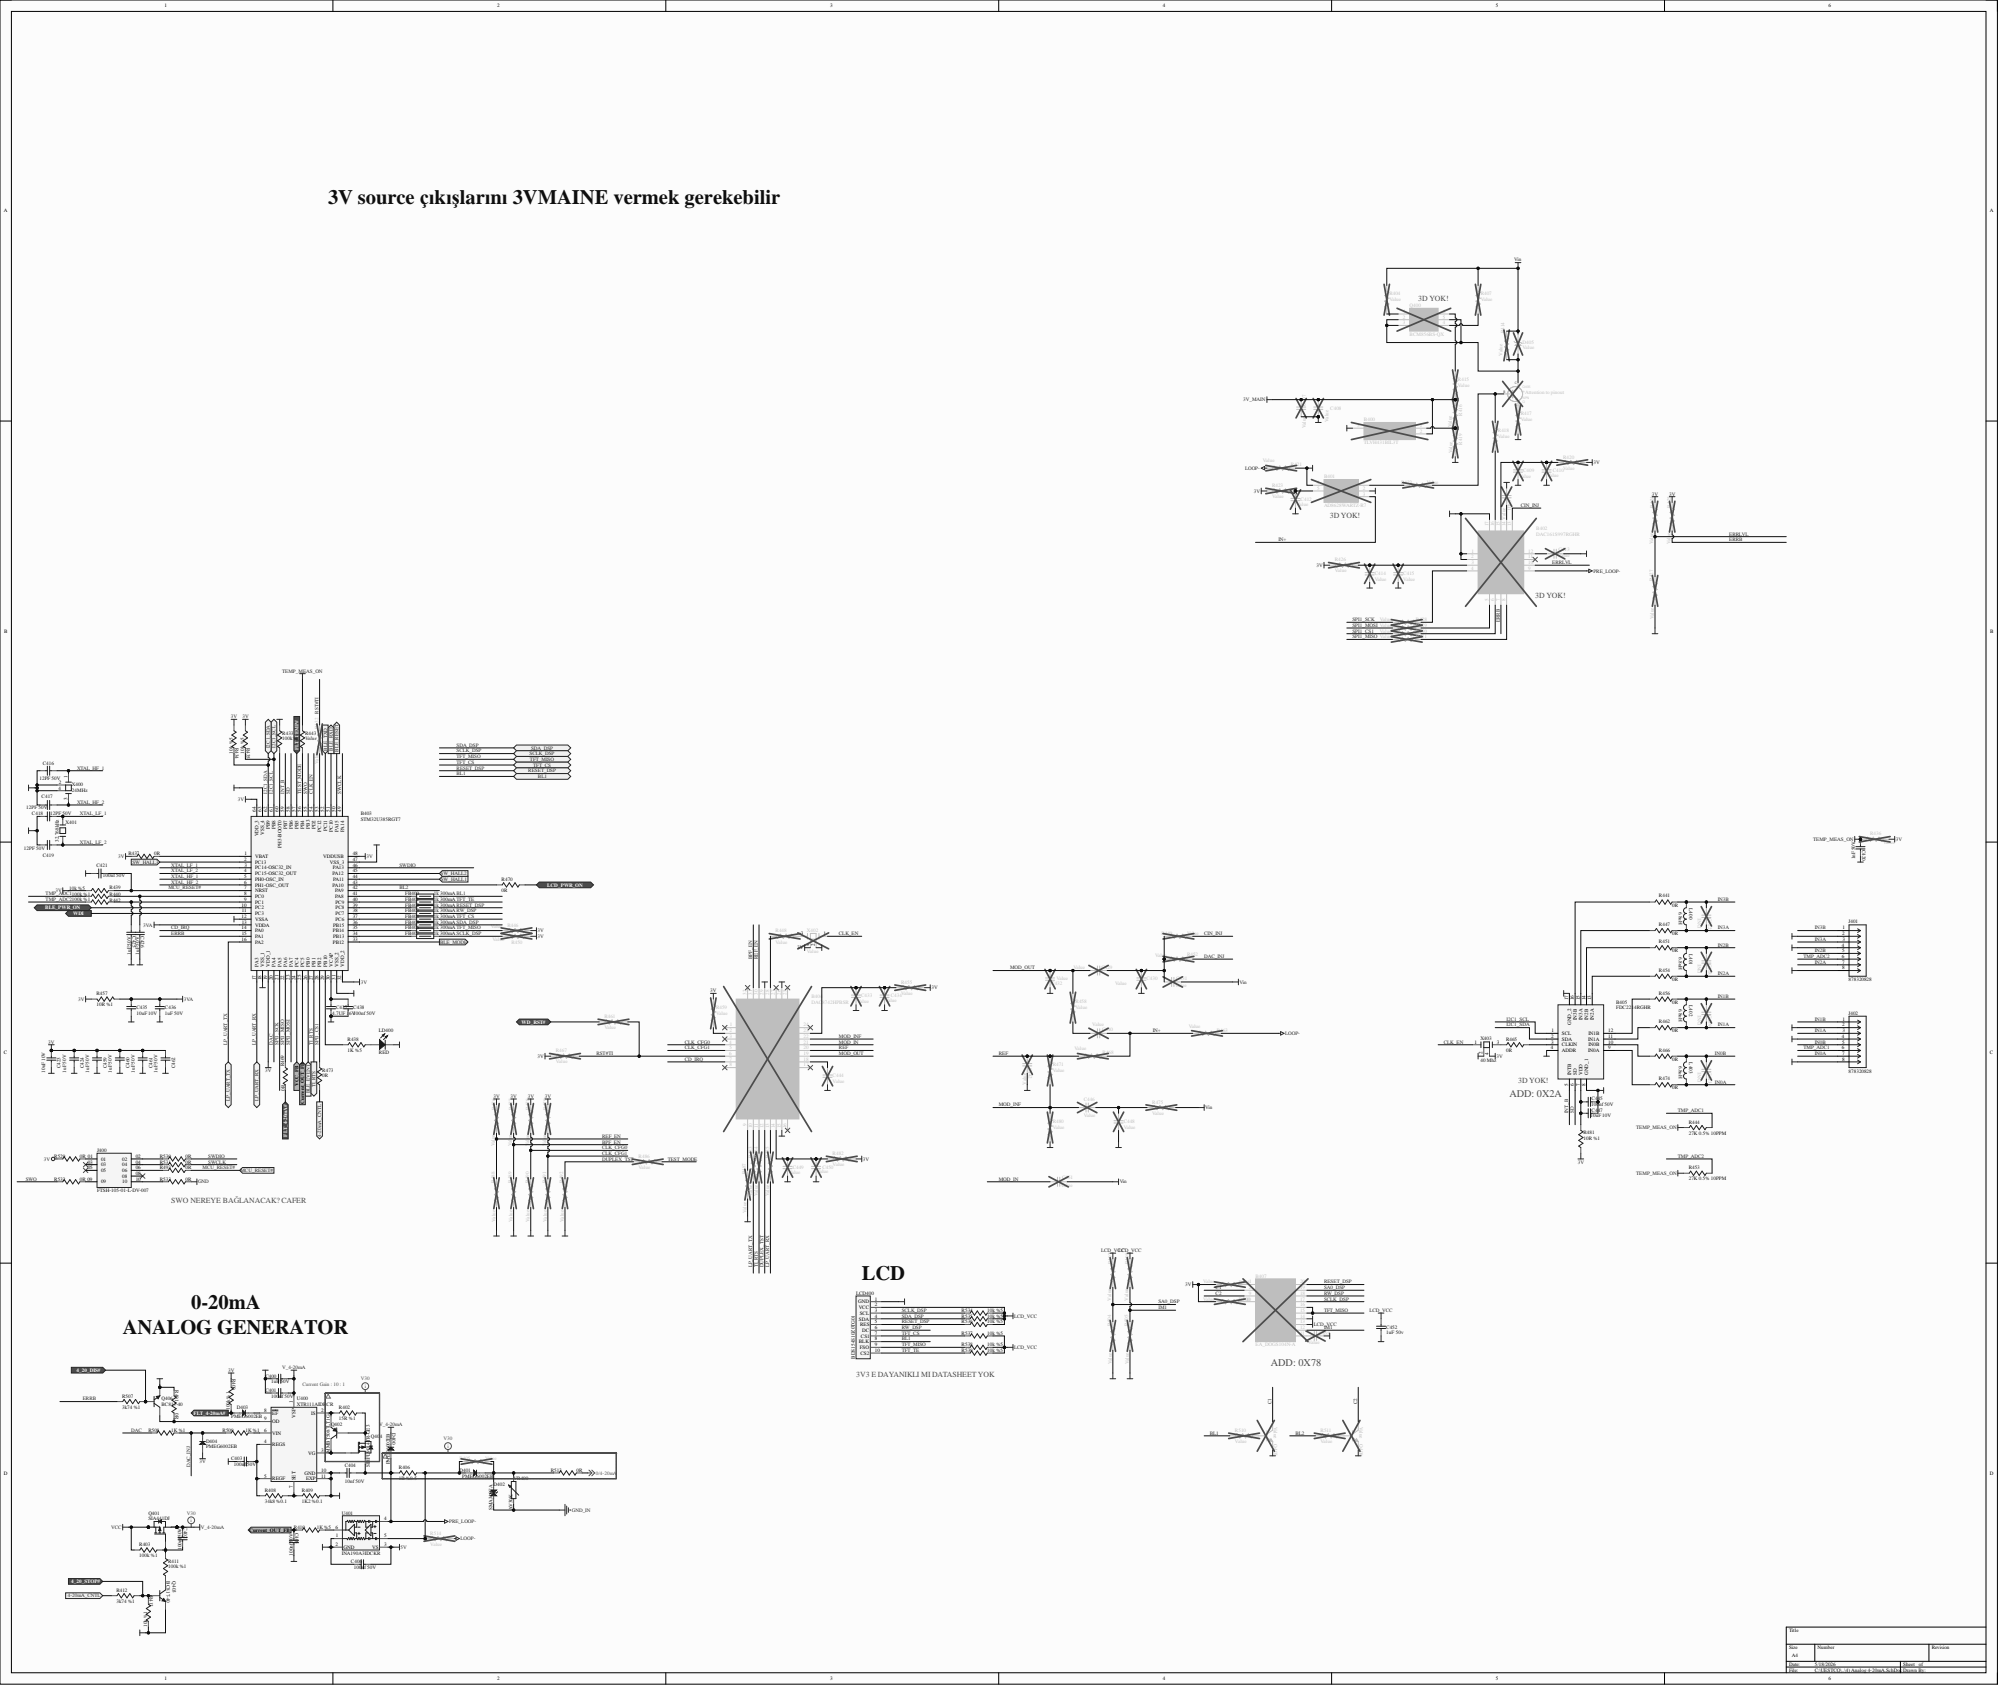
[picture p4: page 4]

3V source çıkışlarını 3VMAINE vermek gerekebilir

SWO NEREYE BAĞLANACAK? CAFER

3V3 E DAYANIKLI MI DATASHEET YOK

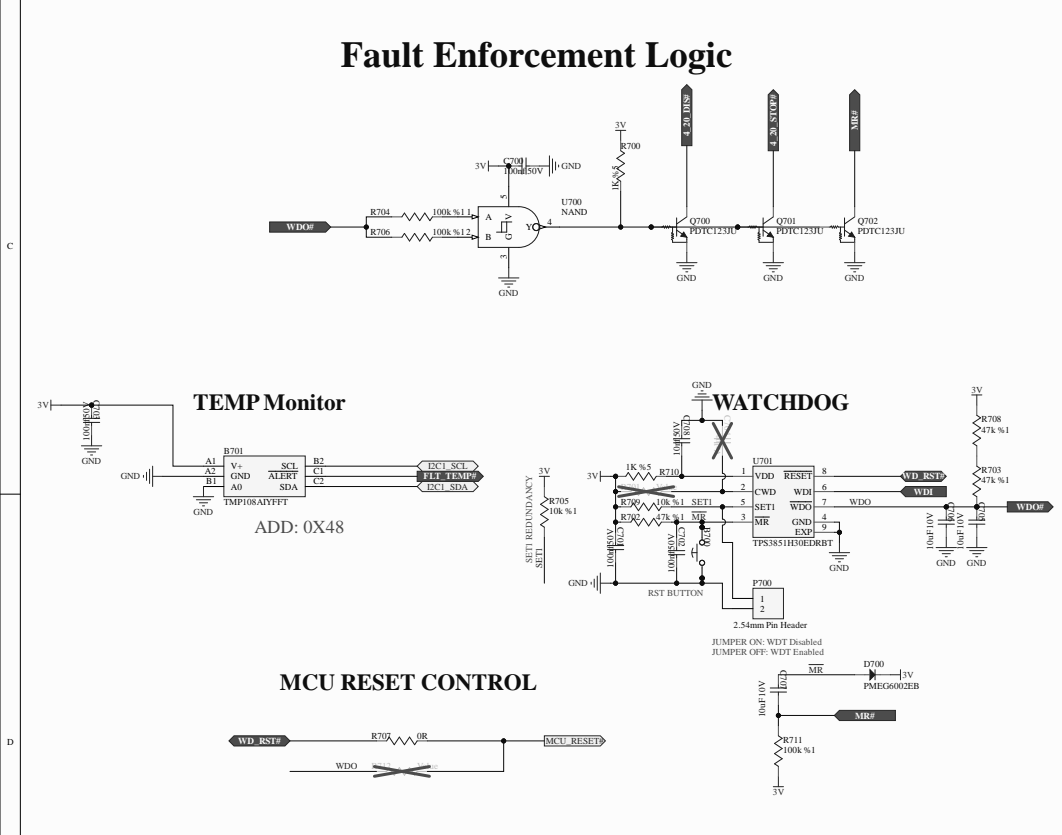
[picture p5: page 5]

JUMPER ON: WDT Disabled
JUMPER OFF: WDT Enabled

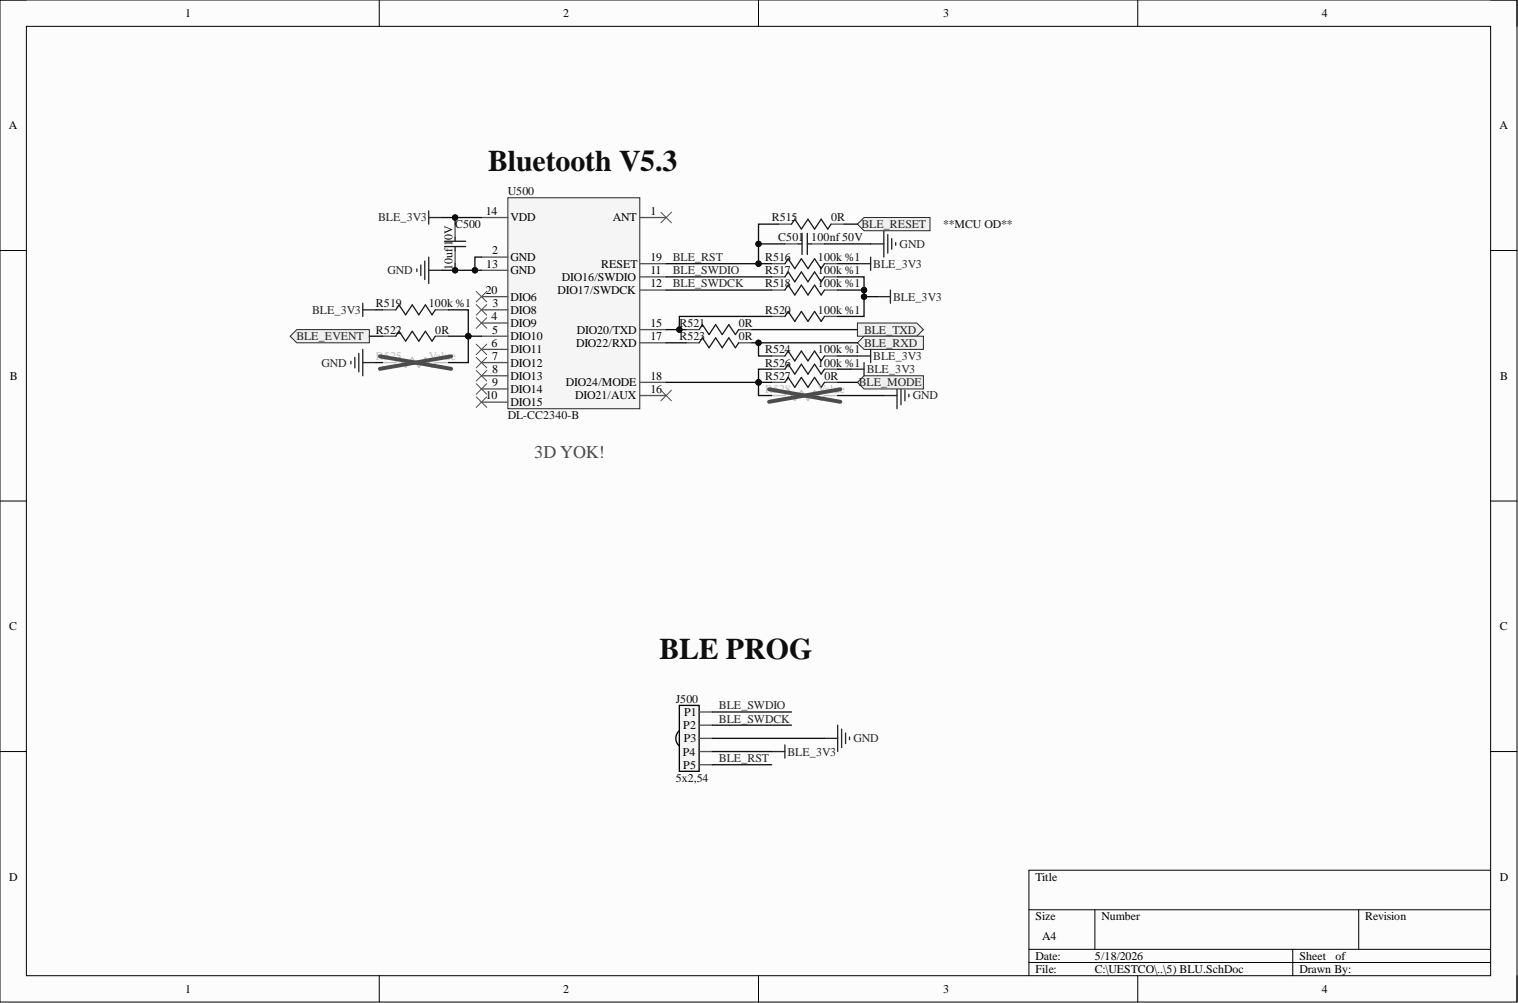
[picture p6: page 6]

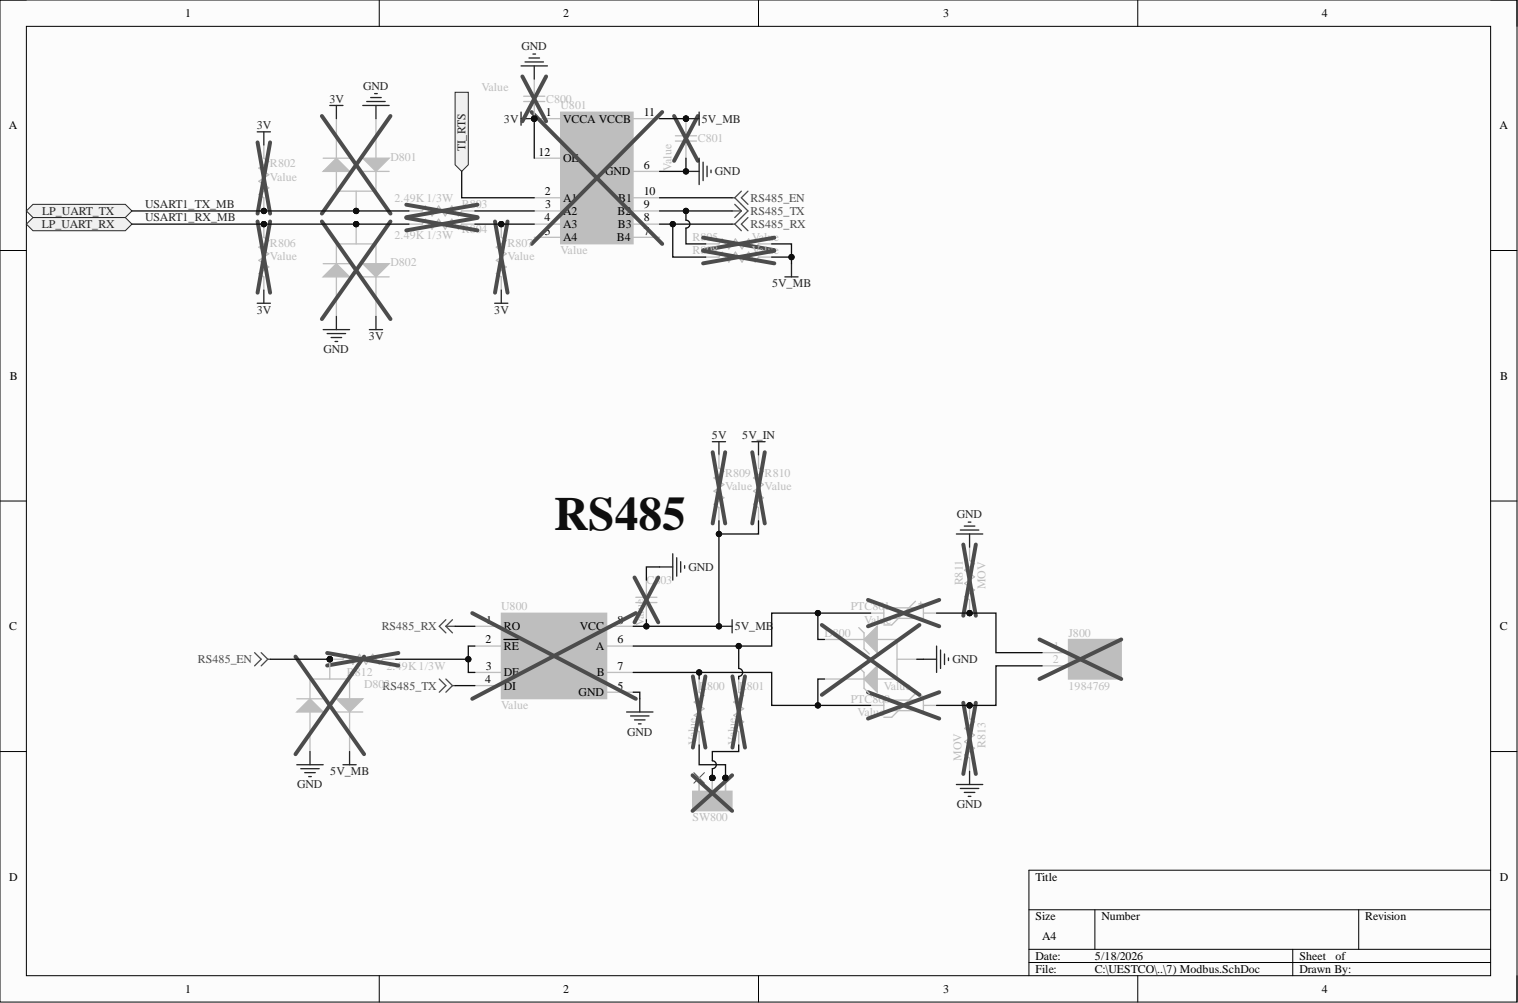
[picture p7: page 7]
