uestcoelectronics/pressure_transmitter/Firmware/Core/Src/main.c

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
/* Includes ------------------------------------------------------------------*/
#include "main.h"
#include "adc.h"
#include "dac.h"
#include "gpdma.h"
#include "i2c.h"
#include "iwdg.h"
#include "spi.h"
#include "tim.h"
#include "usart.h"
#include "gpio.h"

/* USER CODE BEGIN Includes */
#include "pressure_app.h"
#include "buttons.h"
#include "xtr111_loop.h"
#include "tmp108.h"
/* USER CODE END Includes */


void SystemClock_Config(void);
/**
  * @brief  The application entry point.
  * @retval int
  */
int main(void)
{

  /* MCU Configuration--------------------------------------------------------*/

  /* Reset of all peripherals, Initializes the Flash interface and the Systick. */
  HAL_Init();

  /* Configure the system clock */
  SystemClock_Config();

  /* Initialize all configured peripherals */
  MX_GPIO_Init();
  MX_GPDMA1_Init();
  MX_ADC1_Init();
  MX_DAC1_Init();
  MX_I2C1_Init();
  MX_IWDG_Init();
  MX_SPI2_Init();
  MX_TIM1_Init();
  MX_USART3_UART_Init();
  /* USER CODE BEGIN 2 */
  pressure_app_init();
  /* USER CODE END 2 */

  /* Infinite loop */
  /* USER CODE BEGIN WHILE */
  while (1)
  {
    pressure_app_loop();
    /* USER CODE END WHILE */

    /* USER CODE BEGIN 3 */
  }
  /* USER CODE END 3 */
}

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
/* USER CODE BEGIN 4 */
/**
 * EXTI Falling-edge callback (HAL otomatik çağırır).
 * 3 Hall butonu (UP/DN/SET) + XTR111 fault input için pinleri yönlendir.
 */
void HAL_GPIO_EXTI_Falling_Callback(uint16_t pin)
{
    if (pin == BTN_UP_Pin)        buttons_on_edge(BTN_ID_UP);
    else if (pin == BTN_DN_Pin)   buttons_on_edge(BTN_ID_DN);
    else if (pin == BTN_SET_Pin)  buttons_on_edge(BTN_ID_SET);
    else if (pin == LOOP_FLT_Pin) loop_on_flt_edge();   /* enable glitch maskeli */
    else if (pin == FLT_TEMP_Pin) tmp108_on_alert_edge();   /* ortam >60 C */
    /* Diğer EXTI'ler (FDC_INT, FDC_ERRB, BLE_EVENT) şimdilik polling */
}
/* USER CODE END 4 */

/**
  * @brief  Period elapsed callback in non blocking mode
  * @note   This function is called  when TIM6 interrupt took place, inside
  * HAL_TIM_IRQHandler(). It makes a direct call to HAL_IncTick() to increment
  * a global variable "uwTick" used as application time base.
  * @param  htim : TIM handle
  * @retval None
  */
void HAL_TIM_PeriodElapsedCallback(TIM_HandleTypeDef *htim)
{
  if (htim->Instance == TIM6)
  {
    HAL_IncTick();
  }
}

/**
  * @brief  This function is executed in case of error occurrence.
  * @retval None
  */
void Error_Handler(void)
{
  /* USER CODE BEGIN Error_Handler_Debug */
  /* User can add his own implementation to report the HAL error return state */
  __disable_irq();
  while (1)
  {
  }
  /* USER CODE END Error_Handler_Debug */
}
#ifdef USE_FULL_ASSERT
/**
  * @brief  Reports the name of the source file and the source line number
  *         where the assert_param error has occurred.
  * @param  file: pointer to the source file name
  * @param  line: assert_param error line source number
  * @retval None
  */
void assert_failed(uint8_t *file, uint32_t line)
{
  /* USER CODE BEGIN 6 */
  /* User can add his own implementation to report the file name and line number,
     ex: printf("Wrong parameters value: file %s on line %d\r\n", file, line) */
  /* USER CODE END 6 */
}
#endif /* USE_FULL_ASSERT */
