uestcoelectronics/pressure_transmitter/Firmware/PressureTransmitter.ioc

Mcu.UserName=STM32U385RGTx
PA1.GPIO_Label=FDC_ERRB
PA1.Signal=GPXTI1
PA10.GPIO_Label=LCD_PWR_ON
PA10.Signal=GPIO_Output
PA11.GPIO_Label=BTN_UP
PA11.Signal=GPXTI11
PA12.GPIO_Label=BTN_DN
PA12.Signal=GPXTI12
PA4.Signal=COMP_DAC11_group
PA6.GPIO_Label=LOOP_FLT
PA6.Signal=GPXTI6
PA8.Signal=S_TIM1_CH1
PB0.GPIO_Label=BLE_EVENT
PB0.Signal=GPXTI0
PB10.GPIO_Label=LED
PB10.Signal=GPIO_Output
PB12.GPIO_Label=BLE_MODE
PB12.Signal=GPIO_Output
PB13.Signal=SPI2_SCK
PB14.Signal=SPI2_MISO
PB15.Signal=SPI2_MOSI
PB2.GPIO_Label=LOOP_EN
PB2.Signal=GPIO_Output
PB5.GPIO_Label=FLT_TEMP
PB5.Signal=GPXTI5
PB6.GPIO_Label=FDC_SD
PB6.Signal=GPIO_Output
PB7.GPIO_Label=FDC_INT
PB7.Signal=GPXTI7
PB8.Signal=I2C1_SCL
PB9.Signal=I2C1_SDA
PC0.Signal=ADC1_IN1
PC1.Signal=ADC1_IN2
PC10.Signal=USART3_TX
PC11.Signal=USART3_RX
PC12.GPIO_Label=RST_TI
PC12.Signal=GPIO_Output
PC13.GPIO_Label=BTN_SET
PC13.Signal=GPXTI13
PC2.GPIO_Label=BLE_PWR_ON
PC2.Signal=GPIO_Output
PC3.GPIO_Label=WDI
PC3.Signal=GPIO_Output
PC4.Signal=ADC1_IN11
PC5.Signal=ADC1_IN12
PC6.GPIO_Label=LCD_CS
PC6.Signal=GPIO_Output
PC7.GPIO_Label=LCD_DC
PC7.Signal=GPIO_Output
PC8.GPIO_Label=LCD_RST
PC8.Signal=GPIO_Output
PC9.GPIO_Label=LCD_CS2
PC9.Signal=GPIO_Output
PD2.GPIO_Label=FDC_CLK_EN
PD2.Signal=GPIO_Output
