uestcoelectronics/pressure_transmitter/Firmware/Core/Inc/main.h

#define BTN_SET_Pin GPIO_PIN_13
#define BTN_SET_GPIO_Port GPIOC
#define BTN_SET_EXTI_IRQn EXTI13_IRQn
#define BLE_PWR_ON_Pin GPIO_PIN_2
#define BLE_PWR_ON_GPIO_Port GPIOC
#define WDI_Pin GPIO_PIN_3
#define WDI_GPIO_Port GPIOC
#define FDC_ERRB_Pin GPIO_PIN_1
#define FDC_ERRB_GPIO_Port GPIOA
#define FDC_ERRB_EXTI_IRQn EXTI1_IRQn
#define LOOP_FLT_Pin GPIO_PIN_6
#define LOOP_FLT_GPIO_Port GPIOA
#define LOOP_FLT_EXTI_IRQn EXTI6_IRQn
#define BLE_EVENT_Pin GPIO_PIN_0
#define BLE_EVENT_GPIO_Port GPIOB
#define BLE_EVENT_EXTI_IRQn EXTI0_IRQn
#define LOOP_EN_Pin GPIO_PIN_2
#define LOOP_EN_GPIO_Port GPIOB
#define LED_Pin GPIO_PIN_10
#define LED_GPIO_Port GPIOB
#define BLE_MODE_Pin GPIO_PIN_12
#define BLE_MODE_GPIO_Port GPIOB
#define LCD_CS_Pin GPIO_PIN_6
#define LCD_CS_GPIO_Port GPIOC
#define LCD_DC_Pin GPIO_PIN_7
#define LCD_DC_GPIO_Port GPIOC
#define LCD_RST_Pin GPIO_PIN_8
#define LCD_RST_GPIO_Port GPIOC
#define LCD_CS2_Pin GPIO_PIN_9
#define LCD_CS2_GPIO_Port GPIOC
#define LCD_PWR_ON_Pin GPIO_PIN_10
#define LCD_PWR_ON_GPIO_Port GPIOA
#define BTN_UP_Pin GPIO_PIN_11
#define BTN_UP_GPIO_Port GPIOA
#define BTN_UP_EXTI_IRQn EXTI11_IRQn
#define BTN_DN_Pin GPIO_PIN_12
#define BTN_DN_GPIO_Port GPIOA
#define BTN_DN_EXTI_IRQn EXTI12_IRQn
#define BLE_RESET_Pin GPIO_PIN_15
#define BLE_RESET_GPIO_Port GPIOA
#define RST_TI_Pin GPIO_PIN_12
#define RST_TI_GPIO_Port GPIOC
#define FDC_CLK_EN_Pin GPIO_PIN_2
#define FDC_CLK_EN_GPIO_Port GPIOD
#define TEST_MODE_Pin GPIO_PIN_4
#define TEST_MODE_GPIO_Port GPIOB
#define FLT_TEMP_Pin GPIO_PIN_5
#define FLT_TEMP_GPIO_Port GPIOB
#define FLT_TEMP_EXTI_IRQn EXTI5_IRQn
#define FDC_SD_Pin GPIO_PIN_6
#define FDC_SD_GPIO_Port GPIOB
#define FDC_INT_Pin GPIO_PIN_7
#define FDC_INT_GPIO_Port GPIOB
#define FDC_INT_EXTI_IRQn EXTI7_IRQn
