uestcoelectronics/pressure_transmitter/(commit log)

2026-06-12 Initial commit: STM32U385 pressure transmitter firmware + docs
    - Firmware: CubeMX + CMake projesi, App katmani (8 modul), 4-20 mA konfig
    - CARD-0.1 dahil: cal_storage flash yazimi DOUBLEWORD (U3 HAL uyumu)
    - docs/MCU programming: ease-me workspace (roadmap, backlog, state, tracker)
    - BOM, DATASHEETS, PIN_MAPPING (FMEDA), sema PDF
    [PCBPT910G1_4_20.xlsx, PCBPT910G1_4_20_HART.xlsx, PCBPT910G1_LP_HART.xlsx, PCBPT910G1_LP_PA.xlsx, PCBPT910G1_MODBUS.xlsx, PIN_MAPPING.xlsx]
2026-06-12 CARD-0.2: bsp_pins.h pin haritasi mutabakati + workspace guncellemeleri
    - bsp_pins.h: FLT_TEMP (TMP108 alert), BLE_PWR_ON/MODE/RESET/EVENT,
    RST_TI, TEST_MODE alias'lari eklendi
    - ADC yorumlari duzeltildi (1N4148, IN13/IN14) + bilinen sorun notu:
    adc.c rank 2/3 kanal atamasi eksik (.ioc duzeltmesi MANUAL-3)
    - ease-me continuity dosyalari guncellendi (CARD-0.1/0.2/0.3 + CORRECTION-01)
    [bsp_pins.h]
2026-06-12 MANUAL-3: CubeMX ADC regenerate (4 kanal) + bsp_pins ADC_RANK guncellemesi
    - .ioc/adc.c: Rank1=IN1(PC0 diyot#1), Rank2=IN2(PC1 diyot#2),
    Rank3=IN11(PC4 VCC_FB), Rank4=IN12(PC5 I_FB) - rank kanal bug'i kapandi
    - bsp_pins.h: ADC_RANK_TDIODE2 eklendi, COUNT=4, IN11/IN12 duzeltmesi
    - Not: PIN_MAPPING.xlsx IN13/IN14 bilgisi hataliydi (CubeMX teyitli)
    [PressureTransmitter.ioc, bsp_pins.h]
2026-06-12 CARD-1.1: FDC2214 uygulama tarafi bring-up
    - Guc/saat siralamasi: SD toggle + X403 oturma beklemeleri (power_sequence)
    - I2C adres otomatik tespiti: 0x2A -> 0x2B fallback (sema teyidine kadar)
    - ERRB polling: asserted -> STATUS oku, latched hata, alarm-low, SENSOR ERR
    - INT_B data-ready gating; temiz okumada otomatik hata temizleme
    - Init basarisizsa bir kez guc cevrimiyle retry
2026-06-12 CARD-1.2: TMP108 ortam izleme + 60C alert (FLT_TEMP#)
    - Yeni tmp108.c/h: adres tarama (0x48-0x4B), config 0x2230 (continuous,
    1 Hz, comparator, POL aktif-LOW, HYS=4C maks), THIGH=60C / TLOW=-50C,
    config+THIGH read-back dogrulamasi (FH/FL maskeli)
    - pressure_app: 1 Hz poll, AMB HOT >60C ekran onceligi; init olumcul degil
    - main.c USER CODE: FLT_TEMP# (PB5) EXTI -> tmp108_on_alert_edge
    - Rol ayrimi korundu: TMP108 kompanzasyona girmiyor (1N4148 isi)
2026-06-12 CARD-1.3: cift 1N4148 kanal (PC0/PC1) + capraz makulluk
    - temp_diode rework: iki kanal, gecerlilik penceresi (200-1000 mV),
    |T1-T2|<=5C tutarlilik, arbitrasyon (ortalama/fallback/son-deger)
    - is_consistent() + kanal bazli tani getter'lari
    - pressure_app: her iki ADC rank'i besleniyor
    - state_machine bug fix: Vf25/TC edit'i birbirini varsayilana ezmiyor
    [state_machine.c, temp_diode.c, temp_diode.h]
2026-06-12 CARD-1.4: sicaklik rolleri entegrasyonu
    - pressure_app: sicaklik mimarisi rol dokumantasyonu (diyot=kompanzasyon,
    TMP108=ortam+60C alert, failover yok, alarm-low yalniz FDC hatasi)
    - Ekran oncelik zinciri: *FAULT* > SENSOR ERR > TDIODE ERR > AMB HOT > OK
2026-06-12 CARD-2.2: kalibrasyon is akisi saglamlastirma
    - CAL_LIVE stabilite penceresi (8 ornek, dC p2p <= 2000): kararsizken
    yakalama reddi, stabil olunca otomatik mesaj temizleme
    - Span yakalama: |dC - zero| >= 10000 kontrolu (SPAN TOO CLOSE)
    - Save & Exit: cal_validate (dC span + p_max > p_min) + flash hata mesaji
    - Exit (no save): kirli durumda cift onay (Discard? SET again)
    - sm_get_info_msg()/sm_cal_live_stable() API + ekran entegrasyonu
    [state_machine.c, state_machine.h]
2026-06-12 CARD-4.1: loop geri besleme makullugu + NAMUR NE43 alarmlari
    - BUG FIX: komut clamp 3.8..20.5 -> 3.6..21.0 (alarm-low 3.6 mA artik
    gercekten uretiliyor; onceden 3.8'e yuvarlaniyordu)
    - NAMUR NE43 sabitleri; pressure_to_ma aralik disi -> 3.8/20.5 saturasyonu
    - Sapma monitoru: |cmd-meas| > 0.3 mA 2 s -> tani bayragi (cikis degismez),
    LED 5 Hz + ekranda LOOP DEV; alarm bolgesinde pasif
    - XTR111 FLT auto-retry (5 s, FLT pin seviyesi kontrolulu)
    - Header transfer fonksiyonu yorumu duzeltildi (R_SET=1.2k, .c otorite)
    [xtr111_loop.c, xtr111_loop.h]
2026-06-13 CARD-3.1: LCD guc sirasi + uretici ST7789V init dizisi
    - Guc/reset zamanlama sabitleri (PA10 settle 50ms, RST low 10ms,
    RST wait 120ms, SLPOUT 120ms) - datasheet/uretici hizali
    - Uretici guc-kontrol + gamma dizisi eklendi (0xB2/B7/BB/C2/C3/C4/C6/D0
    + 0xE0/E1 gamma) - eksikti, sonuk/yanlis kontrast riski kapandi
    - SWRESET kaldirildi (HW reset yeterli); CS2 makro kullanimi
    - Backlight DISPON sonrasi (acilista garbage flash yok)
    [lcd400.c]
2026-06-13 CARD-3.2: menu SM iyilestirmeleri (timeout/sayfalar/alarm/backlight)
    - 60 s eylemsizlik timeout -> NORMAL (kaydedilmemis degisiklik iptal)
    - NORMAL'de UP/DN ile 3 sayfa: MAIN (P/I/T), SENSOR (dC/Td1/Td2/Tamb),
    LOOP (cmd/meas/err mA)
    - Loop fault'ta adanmis alarm ekrani (render_fault)
    - Backlight (%) menu ogesi - canli lcd_set_backlight, runtime (kalici degil)
    - sm_tick() zaman tabani; menu 12 oge
2026-06-13 CARD-6.2: temel tanilar (diag modulu)
    - Yeni diag.c/h: A.13 ADC rail-stuck (VCC_FB/I_loop, divider-bagimsiz),
    A.7 output GPIO read-back (ODR<->IDR: LOOP_EN/LCD_PWR/BLE_PWR/CLK_EN),
    I2C fiziksel bus recovery (9-clock + STOP + reinit)
    - pressure_app: diag_service sensor tikinde; LOOP_EN read-back kritik ->
    safe state; I2C iki cihaz takilirsa recovery + reinit (cooldown'lu);
    ekranda DIAG CHK
    - diag driver'lara dokunmaz (saglik mevcut API ile gozlenir)
    [diag.c, diag.h]
2026-06-13 CARD-5.1: BLE UART tasima katmani (DL-CC2340-B)
    - Yeni ble_uart.c/h: USART3 IT RX ring buffer (256B, overflow sayacli),
    bloklamali TX; guc sirasi (PWR_ON+MODE wake+RESET darbe+120ms);
    AUX (DIO21->BLE_EVENT) data-ready erisimi
    - USART3 IRQ CubeMX'te kapaliydi -> .ioc DEGISTIRMEDEN app'ten HAL_NVIC
    enable + USART3_IRQHandler ble_uart.c'de (startup zayif sembol override)
    - Datasheet (C19273634.pdf) analizi: baud 115200 uyumlu, pin esleme,
    AT formati, URC'ler -> web_research; MANUAL-5 done
    [ble_uart.c, ble_uart.h]
2026-06-13 CARD-5.2: BLE konfig protokolu (AT init + CRC16 cerceve)
    - Yeni ble_proto.c/h: non-bloklayan AT init SM (RESET->ADVNAME PT910->
    ADVSTA=1->ENTM, OK bekleme+timeout/retry+degraded fallback)
    - Transparent CRC16-CCITT cerceve protokolu [0xAA|LEN|CMD|PAYLOAD|CRC16]:
    GET_MEAS/GET_PARAM/SET_PARAM/SAVE/INFO/UNLOCK; 9 cal parametresi;
    yazma korumasi sabit PIN UNLOCK; vf25/tc temp_diode senkron
    - pressure_app: ble_proto_init + dongu servisi (status byte bitfield)
    - 4-20 guvenlik dongusu BLE bring-up sirasinda durmaz (non-bloklayan)
    [ble_proto.c, ble_proto.h]
2026-06-13 docs: flash/debug altyapisi — Claude headless flash+GDB yapabilir
    - mcu_prog_flash_debug.md: tum araclar kurulu (Programmer CLI v2.21 +
    ST-LINK_gdbserver 7.13 + arm-none-eabi-gdb); is bolumu; komutlar
    - tools/: flash.bat, probe_test.bat, gdb_server.bat, gdb_cmds_example.txt
    - capabilities/memory/manual guncellendi: flash+canli debug Claude'da,
    tek fiziksel onkosul ST-Link takili olmasi
2026-06-13 DBG-SWO: SWO/ITM canli telemetri kanali
    - Yeni dbg_swo.c/h: ITM port 0'a 1 Hz P,T,I,ST satiri; CMSIS
    ITM_SendChar -> SWV yoksa no-op (sifir maliyet, core halt yok)
    - PB3=SWO (AF0) zaten konfigli; firmware TRCENA + ITM yazar,
    trace baud'u debugger ayarlar
    - pressure_app: dbg_swo_init + dongu telemetri; flash_debug.md okuma notu
2026-06-23 bring-up CARD-7.1: ADC DMA fix + FDC okuma + loop enable + 4-20mA kalibrasyonu
    Canli donanim bring-up (2026-06-23, multimetre + HOTPLUG debug ile dogrulandi):
    - ADC: one-shot DMA (CubeMX regenerate) - overrun/IRQ storm fix, 4 kanal taze
    - FDC2214: drive max/settle/full-current config; okuma canli (s_disp_dc degisiyor)
    - Loop FLT power-up glitch maskesi (loop_on_flt_edge + settling level check) -> PB2 stabil
    - 4-20mA cikis kalibrasyonu: kod=144.5*mA+121 (4/12/20mA tam, 2-nokta uc-trim)
    GECICI bring-up scaffolding (sonra temizlenecek):
    - pressure_app FDC read-gating bypass (if(1)) - FDC2214'te ERRB pini yok, PA1 hayalet
    - g_loop_dbg_dac/g_loop_dbg_ma + loop_dbg_apply (kalibrasyon hook'lari)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
    [PressureTransmitter.ioc, fdc2214.c, main.c, xtr111_loop.c, xtr111_loop.h]
2026-06-25 CARD-7.1 + CARD-3.3: ekran metrik fix, TEMP_MEAS_ON, cal_save flash fix, stabilite eşiği
    - CARD-3.3: ekranda float metrikler boştu (nano-printf %f yok) -> fmt_fixed
    helper + 10 %f cagrisi integer formatlamaya cevrildi (pressure_app.c).
    - TEMP_MEAS_ON (PB4): diyot bias enable, app'te Output PP+HIGH (bsp_pins.h +
    pressure_app.c). Pin haritasinda TEST_MODE etiketli; tasarimci teyidi.
    - cal_save FLASH WRITE ERR cozuldu (cal_storage.c): STM32U3 128-bit ECC ->
    16-bayt yuvarlama + geri-okuma dogrulamasi + flag clear + 3x retry.
    - Kalibrasyon stabilite esigi CAL_STAB_P2P_MAX 2000->6000 (state_machine.c).
    - FDC drive: IDRIVE=31 korundu (IDRIVE=20 denendi, osilasyon costu; fdc2214.c yorum).
    -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
    [bsp_pins.h, cal_storage.c, fdc2214.c, state_machine.c]
2026-06-30 @ cleanup: eski "Firmware - yedek" klasoru kaldirildi + PIN_MAPPING.xlsx guncellendi
    @
    [PIN_MAPPING.xlsx]
2026-07-14 cal_storage FLASH WRITE ERR
    fixes FLASH WRITE ERR on repeated save
    [cal_storage.c]
2026-07-14 FIX: TDIODE ERR
    temp_diode tek-kanal moduna alındı (TEMP_DIODE_ACTIVE_CH=1); çift kanal arbitrasyonu/5 °C eşiği kaldırıldı; hata bayrağı artık yalnız gerçek diyot arızasında. SENSOR sayfası tek Td + Vf(mV) gösteriyor.
    [temp_diode.c, temp_diode.h]
